omarquet/minitel-gpt/README.md

# MINITEL GPT

Transformer un **Minitel** en terminal de chat IA, servi par un conteneur
Docker hébergé sur un VPS, relié au Minitel par un
**ESP32** qui fait le pont entre le port série (DIN5, Vidéotex) et une
**WebSocket sécurisée (wss)**.

Fork de [jherard-fr/minitel-gpt](https://github.com/jherard-fr/minitel-gpt),
qui pilote le Minitel directement depuis un Raspberry Pi (port série local).
Ce fork remplace entièrement le Pi et le port série par la chaîne suivante :

```
Minitel --DIN5 1200 7E1--> ESP32 (UART) --WiFi wss://--> reverse proxy --> conteneur minitel-gpt
```

On tape sa question sur le clavier du Minitel, le serveur interroge le modèle
d'IA choisi - **Mistral**, **Claude** ou **Gemini** - et affiche la réponse à
l'écran, à 1200 bauds. Le fournisseur, la clé et le modèle se règlent depuis
l'interface web, tout comme la personnalité de l'assistant (la version phare
est « bloquée dans les années 80 »).

Deux pages viennent avec :

- **[La dictée vocale](#dicter-depuis-un-téléphone)** (`/dictee`) - on parle
  dans son téléphone, ça s'écrit sur le Minitel. Le clavier de 1982 reste sous
  les doigts de celui qui veut s'y frotter, et les autres dictent. Effet
  garanti.
- **[L'émulateur](#tester-sans-matériel)** (`/minitel.html`) - un Minitel
  complet dans le navigateur, même protocole que le vrai. De quoi tout essayer
  pendant que le tien attend encore son fer à souder.

---

## Déploiement

Voir [DEPLOY.md](DEPLOY.md) pour la procédure pas à pas (fork GitHub, serveur,
variables d'environnement, test sans matériel).

Variables d'environnement principales (`.env.example` à la racine) :

| Variable | Rôle |
|---|---|
| `LLM_PROVIDER` | `mistral` (défaut), `claude` ou `gemini` |
| `MISTRAL_KEY`, `MISTRAL_MODEL` | Clé et modèle Mistral |
| `ANTHROPIC_KEY`, `CLAUDE_MODEL` | Clé et modèle Claude |
| `GEMINI_KEY`, `GEMINI_MODEL` | Clé et modèle Gemini |
| `ADMIN_PASSWORD` | Mot de passe de l'admin web |
| `FLASK_SECRET` | Clé de signature des sessions Flask (mets une vraie valeur aléatoire en prod) |
| `ADMIN_PUBLIC_URL` | URL admin affichée sur le Minitel via la touche GUIDE |
| `WS_TOKEN` | Jeton requis en `?token=...` pour se connecter à `/ws` (voir [Sécurité](#sécurité)) |

## Tester sans matériel

Ouvre `https://<ton-domaine>/minitel.html` : un émulateur Minitel dans le
navigateur qui parle le même protocole WebSocket binaire que l'ESP32 (rendu
Vidéotex 40 colonnes, boutons pour les touches de fonction). L'URL WebSocket
et le jeton (`WS_TOKEN`) sont saisissables dans l'interface.

C'est le seul moyen d'essayer le serveur complet - personnalités, pagination,
touches de fonction - sans Minitel, sans ESP32 et sans la moindre soudure. Il
sert aussi à vérifier un déploiement avant de brancher le matériel.

## Dicter depuis un téléphone

Ouvre `https://<ton-domaine>/dictee` : une page pensée pour Safari sur iPhone,
qui écrit sur le Minitel **dans la session en cours**. Le clavier d'un Minitel
est lent et déroutant pour qui ne l'a jamais pratiqué ; là, le visiteur dicte
au micro du clavier natif de son téléphone et le texte s'affiche sur l'écran du
Minitel, caractère par caractère, comme s'il avait été tapé.

Deux modes : **Direct**, où le texte part au fil de la dictée, et **Valider**,
où l'on se relit avant d'envoyer. Les boutons `ENVOI` et `Effacer` reproduisent
les touches correspondantes.

Le téléphone ne se connecte pas à `/ws` - il ouvrirait une deuxième
conversation au lieu d'écrire dans celle du Minitel. Il passe par
`/dictee/inject`, qui dépose les caractères dans la session existante. Deux
conséquences à connaître :

- il faut **une session Minitel ouverte** ; sans elle, la page le dit et
  n'envoie rien ;
- ce qui est dicté pendant la lecture d'une réponse **attend son tour**, les
  caractères n'étant consommés que lorsque le terminal attend une question.

Le jeton (`WS_TOKEN`) se saisit une fois et reste dans le `localStorage` du
téléphone : la page est faite pour passer de main en main, le jeton n'y est
affiché nulle part. Un bouton permet de l'oublier.

## Sécurité

`/ws` (et les endpoints de test `/ws-echo`, `/ws-gemini`) n'ont **aucune
authentification par défaut** : n'importe qui connaissant l'URL publique peut
discuter avec l'assistant et consommer ta clé API. Configure `WS_TOKEN` (une
valeur aléatoire, ex. `python3 -c "import secrets; print(secrets.token_hex(32))"`)
pour exiger `?token=...` sur la connexion WebSocket. L'ESP32 doit alors inclure
le même jeton dans `WS_PATH` (voir le firmware).

Le même jeton protège les deux routes de données de la dictée,
`/dictee/status` et `/dictee/inject` (403 sans lui). La **page** `/dictee`,
elle, est servie sans jeton, volontairement : l'exiger le laisserait dans
l'URL, donc dans l'historique du téléphone. Elle ne contient aucun secret et
ne sert à rien sans jeton.

L'écran affiché sur la touche **GUIDE** ne montre que l'URL de l'admin, jamais
le mot de passe (contrairement au Pi d'origine, où seul le foyer avait un
accès physique au Minitel - ici `/ws` est public). Il permet aussi de changer
de personnalité active directement depuis le Minitel.

---

## Matériel (ESP32-C3)

> **Le firmware est écrit pour un ESP32-C3**, et son brochage lui est propre.
> Sur cette puce, UART0 sert à la console USB et **les GPIO11 à GPIO17 sont
> réservés à la mémoire flash** : les GPIO16/17 des projets ESP32 classiques
> sont donc inutilisables ici. Le pont utilise **UART1 sur GPIO4 (RX) et
> GPIO5 (TX)**. Pour une autre carte ESP32, seuls les numéros de broches et le
> numéro d'UART changent (en tête de `firmware/firmware.ino`) - le reste du
> code est portable.

| Élément | Détail |
|---|---|
| ESP32-C3 | Carte de dev WiFi. LED de statut sur `GPIO8` (logique inversée), bouton BOOT sur `GPIO9` |
| Adaptation de niveau | Une résistance de 10 k en pull-up, ou un TXS0108E - voir la fiche d'atelier |
| MP1584EN | Optionnel : abaisseur 12 V → 5 V pour alimenter l'ESP32 depuis le Minitel |
| Minitel | Prise DIN 5 broches « péri-informatique » |

> ⚠️ **Piège matériel** : le port DIN du Minitel est en **5 V**, les GPIO de
> l'ESP32-C3 en **3,3 V non tolérants 5 V**. Ne jamais relier la ligne TX du
> Minitel directement à une entrée.

> ⚠️ **Le brochage DIN-5 n'est pas séquentiel** : côté broches de la fiche mâle
> du câble (celle qu'on tient en main), c'est **3 - 5 - 2 - 4 - 1**.

### Câblage

| DIN Minitel | ESP32-C3 | Rôle |
|---|---|---|
| broche 1 | `GPIO5` (UART1 TX) | ESP32 → Minitel |
| broche 3 | `GPIO4` (UART1 RX), via pull-up ou TXS0108E | Minitel → ESP32 |
| broche 2 | `GND` | Masse commune |
| broche 5 | MP1584EN réglé à 5 V → broche `5V` | **12 V mesurés** : alimentation optionnelle, jamais en direct |
| broche 4 | **ne pas toucher** | 5 V mesurés, à isoler |

Paramètres série : **1200 bauds, 7 bits, parité paire, 1 stop (7E1)** - norme
Videotex, gérés par l'UART de l'ESP32 (`SERIAL_7E1`).

> 📄 **Le montage complet est décrit dans [`documentation/fiche-atelier.md`](documentation/fiche-atelier.md)**,
> imprimable en PDF : trois montages au choix, brochage détaillé, couleurs des
> fils, tests au multimètre et dépannage.

### Firmware

`firmware/firmware.ino` - relais transparent octet à octet entre
l'UART du Minitel et une connexion WebSocket cliente (lib **WebSockets** de
Markus Sattler / Links2004, disponible dans le gestionnaire de bibliothèques
Arduino). À configurer avant flash, dans `firmware/secrets.h` (modèle :
`secrets.h.example`) : réseaux WiFi, `WS_HOST_PROD`, `USE_LOCAL` et le jeton
`WS_TOKEN_ENC` URL-encodé. Le `.ino` ne contient aucune valeur d'installation
et refuse de compiler si l'une manque.

---

## Interface d'administration

`https://<ton-domaine>/` - mot de passe défini par `ADMIN_PASSWORD`.

- **Personnalités** : créer / modifier / supprimer des presets, prompt système
  en éditeur multi-lignes (laissé vide, le défaut du dépôt s'applique - voir
  plus bas), génération de prompt par IA, **fichiers de connaissance** (.txt)
  injectés dans le contexte, textes d'accueil personnalisables, zone de test
  sans le Minitel.
- **Paramètres** : choix du **fournisseur d'IA** (Mistral, Claude, Gemini) avec
  la clé et le modèle de chacun, logs.

Les personnalités sont stockées dans `config/prompts.json` (créé au premier
démarrage depuis `config/prompts.default.json`, non versionné), leurs fichiers
de connaissance dans `config/knowledge/<personnalité>/` - tout ça vit dans le
volume Docker persistant, pas dans le dépôt git.

Le prompt système se lit en **deux couches** :

1. le champ `prompt` de `config/prompts.json`, s'il est renseigné - c'est la
   personnalisation écrite depuis l'admin web ;
2. sinon le fichier texte désigné par `prompt_file`, dans `config/prompts/` -
   c'est le défaut fourni par le dépôt.

Le défaut reste donc **vivant** : tant que personne n'a rien saisi dans l'admin,
modifier le `.txt` du dépôt et redéployer suffit à changer la personnalité. Un
`.txt` est bien plus lisible qu'une chaîne JSON échappée sur une seule ligne.
L'admin affiche sous le champ lequel des deux est utilisé ; un champ vide n'est
pas un prompt vide.

> Les personnalités/prompts sont pris en compte immédiatement (relus à chaque
> conversation). En revanche, changer la clé/le fournisseur LLM dans
> **Paramètres** ne s'applique au terminal Minitel qu'après un redéploiement
> du serveur (les mises à jour de code aussi passent par un redéploiement après
> `git push`, plus de bouton "mettre à jour" dans l'admin).

---

## Touches du Minitel

| Touche | Effet |
|---|---|
| **ENVOI** | Envoie la question tapée |
| **SOMMAIRE** | Retour au menu principal (recharge le preset, réinitialise la conversation) |
| **GUIDE** | Change de personnalité active (touche numérique), affiche aussi l'URL de l'admin |
| **RETOUR** / **CORRECTION** | Efface le dernier caractère tapé. Pendant la lecture d'une réponse multi-pages, RETOUR revient à la page précédente (autant de fois que nécessaire). Une fois la question suivante affichée (saisie vide), RETOUR rouvre directement l'avant-dernière page de la dernière réponse (pas la dernière, déjà vue) - SUITE termine la révision |
| **ANNULATION** | Efface toute la phrase en cours de saisie |
| **REPETITION** | Réaffiche la dernière réponse de l'assistant (sans nouvel appel API) |
| **SUITE** | Page suivante (réponse sur plusieurs écrans) |

---

## Arborescence

```
services/
  server.py             point d'entrée VPS : admin + WebSocket /ws
  minitel_gpt.py        écrans, lecture clavier, appel LLM (Mistral/Claude/Gemini)
  admin_ui.py           interface web d'admin
config/
  prompts.default.json  personnalités par défaut (prompts.json créé au 1er boot)
  prompts/*.txt         prompts système par défaut, référencés par `prompt_file`
firmware/
  firmware.ino          pont UART <-> WebSocket (sketch Arduino)
  secrets.h.example     modèle de secrets.h (WiFi + token WS, non versionné)
minitel.html             émulateur Minitel dans le navigateur (test sans matériel)
dictee.html              page de dictée vocale depuis un téléphone (servie sur /dictee)
Dockerfile, docker-compose.yml, entrypoint.sh
DEPLOY.md                procédure de déploiement
```

---

## Dépannage

| Symptôme | Cause probable |
|---|---|
| 502 Bad Gateway sur toutes les routes | conteneur pas démarré/joignable - vérifie les logs du serveur et le port du healthcheck (doit être celui de `EXPOSE` dans le Dockerfile, pas un défaut générique) |
| `minitel.html` ne se connecte pas | mauvais protocole (`wss://` pas `ws://` derrière le reverse proxy/HTTPS), `WS_TOKEN` manquant dans l'URL si configuré côté serveur, ou pas de port dans l'URL publique (le reverse proxy route en 443 en interne vers le port du conteneur) |
| Erreur API (401/403) sur les réponses | clé du fournisseur actif (`LLM_PROVIDER`) absente ou invalide |
| Rien ne s'affiche sur le vrai Minitel | câblage DIN délogé, level shifter absent/mal branché, broche 4 pontée par erreur, ou brochage DIN mal identifié (l'ordre physique n'est pas 1-2-3-4-5, voir plus haut) |
| Charabia à l'écran | vitesse ESP32 ≠ vitesse Minitel (rester à 1200 bauds 7E1 des deux côtés) |

---

*Projet personnel de Jérôme Hérard pour la version originale Raspberry Pi.*
