omarquet/minitel-gpt/DEPLOY.md

# Déploiement minitel-gpt sur VPS (ESP32 + WebSocket)

Ce dépôt tourne en conteneur Docker (Flask + gunicorn), sans dépendance au
matériel Raspberry Pi de l'upstream d'origine.

## 1. Récupérer le dépôt

Fork ou clone direct de https://github.com/omarquet/minitel-gpt selon ton
usage.

## 2. Déploiement sur ton serveur

1. Nouvelle app/service à partir de ton fork, en Docker Compose (ou Dockerfile).
2. Environment :
   - `LLM_PROVIDER=mistral` (ou `claude` / `gemini`)
   - `MISTRAL_KEY=...`  `MISTRAL_MODEL=mistral-small-latest` (si `LLM_PROVIDER=mistral`)
   - `ANTHROPIC_KEY=...`  `CLAUDE_MODEL=claude-haiku-4-5` (si `LLM_PROVIDER=claude`)
   - `GEMINI_KEY=...`  `GEMINI_MODEL=gemini-3.5-flash-lite` (si `LLM_PROVIDER=gemini`)
   - `ADMIN_PASSWORD=...`  `FLASK_SECRET=...`
   - `ADMIN_PUBLIC_URL=https://minitel.tondomaine.fr`
   - `WS_TOKEN=...` (recommandé) : sans ça, `/ws` est ouvert à qui connaît
     l'URL et peut consommer ta clé API. Avec un token, l'ESP32 et tes tests
     doivent ajouter `?token=...` à l'URL WebSocket.

   Les clés et modèles des trois fournisseurs cohabitent : basculer de l'un à
   l'autre ne fait pas perdre la configuration des autres. Les identifiants de
   modèles vieillissent vite - Google a retiré `gemini-2.0-flash`, qui répond
   maintenant `404 no longer available`. La liste à jour est celle des
   sélecteurs de l'admin (onglet **Paramètres**).
3. Domaine `minitel.tondomaine.fr`, port exposé **8080** (le reverse proxy gère TLS + WebSocket).
   ⚠️ Vérifie aussi le **port du healthcheck** dans la config de ton serveur : il
   revient parfois à une valeur par défaut (ex. 3000) qui ne correspond pas au
   port réel du conteneur (8080) - ça provoque un 502 permanent même si l'app
   tourne parfaitement (visible dans les logs : `Healthcheck URL: .../3000/healthz`).
4. Déploie.
   - Admin : `https://minitel.tondomaine.fr/`
   - Endpoint Minitel/ESP32 : `wss://minitel.tondomaine.fr/ws`

## 3. Tester sans ESP32

En local :
```bash
docker compose up --build
```
Ouvre `minitel.html`, URL `ws://localhost:8080/ws`, clique **Connecter**.
Tape une question, **Entrée** = ENVOI ; boutons SUITE / SOMMAIRE / GUIDE.

Une fois déployé sur ton serveur, pointe l'émulateur sur `wss://minitel.tondomaine.fr/ws`
pour valider le VPS avant toute soudure.

## 4. Matériel ESP32 (rappel critique)

Le port DIN du Minitel est en **5 V**, les GPIO de l'ESP32 en **3,3 V non
tolérants 5 V**. Un **adaptateur de niveau logique bidirectionnel** (BSS138 /
TXS0108E) est obligatoire entre les deux. Câblage détaillé dans le `.ino`.
