omarquet/minitel-gpt/firmware/firmware.ino

/*
 * minitel_esp32_bridge.ino
 * ------------------------------------------------------------------
 * Pont TRANSPARENT entre le Minitel (UART DIN5, 1200 7E1) et le service
 * minitel-gpt heberge sur le VPS Coolify, via WebSocket securise (wss).
 *
 * L'ESP32 ne fait AUCUN traitement Videotex : il relaie les octets bruts.
 *   Minitel -> UART RX -> WebSocket (frame binaire) -> serveur
 *   serveur  -> WebSocket (frame binaire) -> UART TX -> Minitel
 *
 * Librairie requise : "WebSockets" de Markus Sattler (Links2004)
 *   -> Gestionnaire de bibliotheques Arduino : chercher "WebSockets by Markus Sattler"
 *
 * CIBLE : ESP32-C3 (RISC-V). ATTENTION, le C3 n'a que DEUX UART (UART0 et
 * UART1) : il n'existe pas d'UART2. UART0 sert a la console USB/debug, on
 * utilise donc UART1. De plus, sur le C3 les GPIO11 a GPIO17 sont reserves a
 * la memoire flash : les GPIO16/17 du projet d'origine sont INUTILISABLES.
 *
 * ============================ CABLAGE ============================
 * DIN5 peri-informatique Minitel  <->  ESP32-C3 (UART1)
 *   DIN broche 1 (Minitel RX)  <-  ESP32-C3 TX (GPIO5)  [via level shifter]
 *   DIN broche 3 (Minitel TX)  ->  ESP32-C3 RX (GPIO4)  [via level shifter]
 *   DIN broche 2 (GND)         <-> ESP32 GND
 *   DIN broche 4 : ne pas toucher.
 *
 * !!! ORDRE DE BRANCHEMENT !!!
 * Le VB du TXS0108E est pris sur la broche 5V de l'ESP32-C3, qui EST le VBUS
 * de l'USB : USB debranche, elle est flottante. Si on branche le DIN en
 * premier, le 5 V du Minitel remonte par les diodes de protection et alimente
 * partiellement la carte (la LED d'alim s'allume faiblement) : rails a une
 * tension partielle, tout est dans un etat indetermine, et le TXS0108E voit
 * VB s'etablir avant VA, l'inverse de ce que demande sa datasheet.
 *   -> BRANCHER : USB d'abord, DIN ensuite.
 *   -> DEBRANCHER : DIN d'abord, USB en dernier.
 *
 * !!! DIN BROCHE 5 : 12 V MESURES sur ce Minitel 2 Alcatel !!!
 * Ne JAMAIS relier cette broche a l'ESP32, ni sur 3V3, ni sur 5V/VIN : sur
 * les petites cartes C3, 5V est cablee au VBUS de l'USB et le regulateur
 * 3,3 V embarque plafonne vers 6 V d'entree -> carte detruite.
 * Pour un montage autonome alimente par le Minitel (sans USB) :
 *   broche 5 -> buck DC-DC 12 V vers 5 V (MP1584, LM2596), tension VERIFIEE
 *   au voltmetre avant branchement -> pin 5V de l'ESP32 + VB du TXS0108E.
 *   Condensateur 470-1000 uF sur le rail 5 V pres de l'ESP32 (les pics de
 *   courant du WiFi font decrocher les petits bucks).
 *   NE PAS cumuler l'USB du Mac et le buck : conflit VBUS / sortie buck sur
 *   le meme rail. Debrancher l'un pour utiliser l'autre (ou diode Schottky
 *   en serie sur la sortie du buck).
 *   Le courant disponible sur la broche 5 est faible et mal documente : le
 *   mesurer en charge WiFi avant de considerer le montage fiable.
 *
 * MODE PERI-INFORMATIQUE FORCE AU DEMARRAGE
 * ------------------------------------------
 * setup() envoie une sequence PRO3 (voir forcerModePeriInformatique()) qui
 * demande au Minitel de router son clavier et son ecran vers la prise
 * peri-informatique, a la place de "Fnct+T puis A" tape a la main. Repetee
 * pendant FORCE_MODE_WINDOW_MS apres le boot (idleTick()/loop()) : le
 * Minitel peut encore etre en train de demarrer lui-meme au moment du tout
 * premier envoi, qui serait alors perdu en silence. Experimental, non
 * verifie sur ce modele (Minitel 2 Alcatel) : si le clavier ne remonte
 * toujours pas sans la manip manuelle, cette sequence n'a pas suffi.
 *
 * CONFIGURATION WIFI SANS ORDINATEUR
 * ----------------------------------
 * Au demarrage, dans l'ordre : le reseau memorise en NVS (choisi une fois sur
 * l'ecran du Minitel), puis la liste WIFI_SSID / WIFI_SSID2 / WIFI_SSID3 de
 * secrets.h. Si rien ne repond, l'ESP32 prend la parole sur le Minitel et
 * propose les reseaux du scan, numerotes : on choisit au chiffre (le SSID ne
 * se tape donc jamais), on saisit le mot de passe, et le reseau retenu est
 * memorise pour les demarrages suivants.
 * Effacer ce reseau memorise : "O" dans ce menu, ou BOOT maintenu 5 s en
 * fonctionnement - le seul recours quand la carte est connectee a un reseau
 * dont on ne veut plus, le menu ne s'affichant alors jamais.
 *
 * Broches C3 a EVITER : GPIO11-17 (flash), GPIO18/19 (USB natif),
 * GPIO20/21 (UART0 console), GPIO2/9 (strapping au boot).
 * GPIO4 et GPIO5 sont libres et sans contrainte de boot.
 * GPIO8 est un strapping pin mais porte la LED de statut de la carte : elle
 * n'est pilotee qu'apres le boot, et son etat de repos est l'etat haut.
 *
 * !!! IMPORTANT NIVEAUX LOGIQUES !!!
 * Le port peri-info du Minitel est en 5 V (c'est pourquoi le projet d'origine
 * met le cavalier FTDI sur 5 V). Or les GPIO de l'ESP32-C3 sont en 3.3 V et NE
 * SONT PAS tolerants 5 V. Il FAUT un adaptateur de niveau logique bidirectionnel
 * (ex. module a base de BSS138, ou TXS0108E) entre le Minitel et l'ESP32 :
 *   - obligatoire sur la ligne Minitel TX (5 V) -> ESP32 RX, sinon tu grilles le GPIO
 *   - recommande aussi sur ESP32 TX (3.3 V) -> Minitel RX pour une marge propre
 * ================================================================
 */

#include <WiFi.h>
#include <Preferences.h>
#include <WiFiClientSecure.h>
#include <WebSocketsClient.h>
#include <esp_system.h>   // esp_reset_reason() : cause du dernier demarrage
// WIFI_SSID / WIFI_PASSWORD / WS_TOKEN_ENC. Fichier ignore par git : le creer
// a partir de secrets.h.example (meme dossier).
#include "secrets.h"

// ============ A CONFIGURER ============
// Serveur, port et transport : dans secrets.h (modele : secrets.h.example).
// Rien de tout cela n'a sa place ici - firmware.ino est du code, pas la
// configuration d'une machine : un nom de domaine ou une IP locale versionnes,
// c'est du fichier suivi par git qu'il faut modifier pour un simple test.
//   USE_LOCAL 1 = serveur sur ta machine, ws:// non chiffre  -> WS_HOST_LOCAL
//   USE_LOCAL 0 = production derriere un reverse proxy, wss:// -> WS_HOST_PROD
#ifndef USE_LOCAL
  #error "secrets.h doit definir USE_LOCAL (voir secrets.h.example)"
#endif
#if USE_LOCAL
  #if !defined(WS_HOST_LOCAL) || !defined(WS_PORT_LOCAL)
    #error "USE_LOCAL 1 : secrets.h doit definir WS_HOST_LOCAL et WS_PORT_LOCAL"
  #endif
#else
  #if !defined(WS_HOST_PROD) || !defined(WS_PORT_PROD)
    #error "USE_LOCAL 0 : secrets.h doit definir WS_HOST_PROD et WS_PORT_PROD"
  #endif
#endif

// 0 = fonctionnement normal.
// 1 = trace sur le moniteur serie tout ce qui arrive du Minitel.
//     Rien = le Minitel n'emet pas. Bons caracteres = liaison OK.
//     Octets incoherents = mauvaise vitesse/format.
// 2 = comme 1, plus emission du motif de test toutes les 2 s. Permet de
//     sonder la ligne au voltmetre et de faire un test de bouclage
//     (GPIO4 relie a GPIO5) sans dependre du timing du RESET.
#define DEBUG_UART 0

#if USE_LOCAL
  const char* WS_HOST = WS_HOST_LOCAL;
  const int   WS_PORT = WS_PORT_LOCAL;
#else
  const char* WS_HOST = WS_HOST_PROD;
  const int   WS_PORT = WS_PORT_PROD;
#endif

// Pour isoler un souci materiel : basculer sur "/ws-echo", ou le serveur
// renvoie les octets tels quels sans appeler le LLM. Revenir a "/ws" ensuite.
#define WS_ENDPOINT "/ws"

// Le serveur (WS_TOKEN) ferme la connexion en SILENCE si le token est absent
// ou faux : symptome = "[WS] connecte" puis "[WS] deconnecte" en boucle.
const char* WS_PATH = WS_ENDPOINT "?token=" WS_TOKEN_ENC;
// ======================================

// UART1 vers le Minitel : 1200 bauds, 7 bits de donnees, parite paire, 1 stop.
// (UART1 et non UART2 : le C3 ne possede pas de troisieme UART.)
// Reseaux connus, essayes dans l'ordre. Les entrees 2 et 3 n'existent que si
// secrets.h les definit : un secrets.h d'avant cette liste continue de
// marcher tel quel, avec un seul reseau.
struct WifiNet { const char* ssid; const char* pass; };
static const WifiNet KNOWN_NETS[] = {
  { WIFI_SSID, WIFI_PASSWORD },
#ifdef WIFI_SSID2
  { WIFI_SSID2, WIFI_PASSWORD2 },
#endif
#ifdef WIFI_SSID3
  { WIFI_SSID3, WIFI_PASSWORD3 },
#endif
};
static const uint8_t KNOWN_COUNT = sizeof(KNOWN_NETS) / sizeof(KNOWN_NETS[0]);
// Identifiants reellement utilises, quelle que soit leur origine : NVS, liste
// de secrets.h ou ecran de configuration. Le filet de reconnexion du loop doit
// relancer CEUX-LA - sinon, connecte via l'ecran de configuration, il tentait
// le premier reseau de secrets.h, qui n'est justement pas la.
static String usedSsid, usedPass;
// Delai laisse a chaque reseau avant de passer au suivant. Assez long pour un
// DHCP lent, assez court pour faire le tour d'une liste de trois sans lasser.
#define WIFI_TRY_MS 12000
// Reseau absent du dernier scan : il peut etre a SSID cache, donc on l'essaie
// quand meme - mais sans y consacrer les 12 s d'un reseau qu'on a vu.
#define WIFI_TRY_ABSENT_MS 4000
// Tours de liste avant de renoncer et d'ouvrir l'ecran de configuration.
#define WIFI_PASSES 3

#define MINITEL_RX 4    // ESP32-C3 RX  <- Minitel TX (broche DIN 3)
#define MINITEL_TX 5    // ESP32-C3 TX  -> Minitel RX (broche DIN 1)
HardwareSerial Minitel(1);

// ---------------------------------------------------------------------------
// Aiguillage automatique en mode peri-informatique (protocole Teletel)
//
// Remplace la manip manuelle "Fnct+T puis A" : la couche "Protocole" du
// Minitel route normalement le clavier vers son modem interne (mode
// Videotex) ; on lui demande ici de router clavier <-> prise
// peri-informatique a la place, par une sequence PRO3 envoyee sur la liaison
// serie elle-meme (rien a cabler de plus, deja sur GPIO5).
//
// Sequence documentee pour le Minitel 1B (bibliotheque Arduino
// Minitel1B_Hard, fonction aiguillage()) : ESC 0x3B (PRO3), AIGUILLAGE_ON,
// recepteur, emetteur. NON VERIFIEE sur ce Minitel 2 Alcatel - la couche
// Protocole fait partie de la norme Teletel commune a toute la gamme, mais
// personne ne l'a encore confirme sur ce modele precis. A surveiller au
// premier essai reel : si le clavier ne remonte toujours pas sans
// Fnct+T+A manuel, cette fonction n'a pas eu l'effet attendu.
#define PRO3           0x3B
#define AIGUILLAGE_ON  0x61
#define CODE_ECRAN     0x58   // reception ecran
#define CODE_CLAVIER   0x51   // emission clavier
#define CODE_PRISE_EM  0x53   // emission prise peri-informatique
#define CODE_PRISE_REC 0x5B   // reception prise peri-informatique

// Date du dernier octet envoye au Minitel. Sert au battement de coeur plus
// bas : seule une ligne SILENCIEUSE doit en recevoir un.
static unsigned long dernierEnvoiMinitelMs = 0;

void aiguillage(uint8_t recepteur, uint8_t emetteur) {
  dernierEnvoiMinitelMs = millis();
  Minitel.write(0x1B);         // ESC
  Minitel.write(PRO3);
  Minitel.write(AIGUILLAGE_ON);
  Minitel.write(recepteur);
  Minitel.write(emetteur);
}

void forcerModePeriInformatique() {
  aiguillage(CODE_PRISE_REC, CODE_CLAVIER);   // clavier -> prise (sens montant)
  aiguillage(CODE_ECRAN, CODE_PRISE_EM);      // prise -> ecran (sens descendant)
  Serial.println("[Minitel] aiguillage force vers la prise peri-informatique (PRO3)");
}

// Un seul envoi ferait reposer tout le mecanisme sur un delai devine : le
// Minitel peut encore etre en train de demarrer lui-meme (sortie de veille,
// reset interne) au moment ou l'ESP32 envoie sa toute premiere sequence,
// qui serait alors perdue en silence. On la repete donc pendant une dizaine
// de secondes plutot que de parier sur un seul instant - inoffensif si le
// Minitel a deja bascule, ca ne fait que reaffirmer le meme aiguillage. La
// fenetre est large parce que le Minitel peut sortir de veille bien apres
// l'ESP32 : mieux vaut insister trop longtemps que rater le reveil.
#define FORCE_MODE_WINDOW_MS 10000  // duree totale des tentatives apres le boot
#define FORCE_MODE_PERIOD_MS 500    // intervalle entre deux tentatives
static unsigned long forceModeUntilMs = 0;
static unsigned long lastForceModeMs = 0;

// A appeler quand on s'apprete a ECRIRE sur le Minitel, et seulement la :
// avant l'ecran de configuration, et une fois le WiFi obtenu. Tant qu'on
// cherche un reseau, le terminal ne doit pas etre touche - on n'a rien a lui
// montrer, et le basculer pour rien lui fait perdre l'affichage qu'il avait.
void ouvrirFenetreAiguillage() {
  forceModeUntilMs = millis() + FORCE_MODE_WINDOW_MS;
  forcerModePeriInformatique();          // premier envoi immediat
  lastForceModeMs = millis();            // les suivants passent par idleTick()/loop()
}


// Le Minitel eteint son ecran quand plus aucun caractere ne lui parvient. La
// STUM 2 documente ce mecanisme avec un delai de trois heures ; celui du
// montage s'endort en cinq a dix minutes, et une session ou personne ne tape
// laisse la ligne parfaitement muette bien plus longtemps que ca. Un octet
// suffit a reculer l'echeance : NUL est un caractere de remplissage Videotex,
// sans aucun effet a l'ecran.
//
// La condition "rien envoye depuis VEILLE_KEEPALIVE_MS" garantit qu'on ne
// s'insere jamais au milieu d'une sequence d'echappement du serveur : par
// construction, on n'ecrit que sur une ligne au repos.
#define VEILLE_KEEPALIVE_MS 120000   // 2 min

void maybeReveilMinitel() {
  if (millis() - dernierEnvoiMinitelMs < VEILLE_KEEPALIVE_MS) return;
  Minitel.write((uint8_t) 0x00);
  dernierEnvoiMinitelMs = millis();
}


void maybeForceModePeriInformatique() {
  if (millis() >= forceModeUntilMs) return;
  if (millis() - lastForceModeMs < FORCE_MODE_PERIOD_MS) return;
  lastForceModeMs = millis();
  forcerModePeriInformatique();
}

// LED de statut integree a la carte, sur GPIO8, en logique INVERSEE.
// GPIO8 est une broche de strapping (doit etre a l'etat haut au boot) : on ne
// la pilote qu'apres le demarrage, et l'etat de repos LED_OFF est justement
// HIGH, donc un reset pendant une phase eteinte demarre normalement.
// Codage : flash bref toutes les 2 s = tout va bien (prouve aussi que loop()
// tourne encore), clignotement lent = WiFi OK mais WebSocket coupee,
// clignotement rapide = WiFi perdu.
#define STATUS_LED 8
#define LED_ON     LOW
#define LED_OFF    HIGH

// Bouton BOUT de la carte. GPIO9 est la broche de strapping qui choisit le
// mode de demarrage : maintenue basse AU RESET, la puce entre en mode
// televersement et n'execute pas ce firmware. On ne la lit donc jamais au
// demarrage, seulement pendant le fonctionnement - ou elle redevient une
// entree ordinaire avec sa resistance de tirage interne.
#define BOOT_BTN 9
// Cinq secondes : BOOT est le SEUL bouton de la carte et un visiteur curieux
// appuiera dessus. Assez long pour etre delibere, assez court pour qu'on ne
// relache pas en croyant que ca ne marche pas.
#define RESET_HOLD_MS 5000
// Appui BREF sur le meme bouton : ouvre l'ecran de configuration sans attendre
// le tour complet des reseaux connus. Demande a la main, pendant qu'on est
// devant le Minitel, plutot que subie apres 36 s d'essais.
#define RESET_TAP_MIN_MS 50
static volatile bool setupRequested = false;

// Reseau appris a l'ecran de configuration, garde en NVS. C'est lui qu'on
// essaie EN PREMIER au demarrage : une fois configure sur place, le boitier
// s'y reconnecte seul.
Preferences prefs;
#define NVS_NS "wifi"

WebSocketsClient webSocket;
bool wsConnected = false;

// Petit tampon pour regrouper les octets clavier avant envoi (moins de frames)
uint8_t txBuf[64];
size_t  txLen = 0;
unsigned long lastByteMs = 0;

// Non bloquant : la phase se deduit de millis(), aucune variable d'etat.
void updateStatusLed() {
  unsigned long onMs, periodMs;
  if (WiFi.status() != WL_CONNECTED) {
    onMs = 100; periodMs = 200;            // rapide : pas de WiFi
  } else if (!wsConnected) {
    onMs = 500; periodMs = 1000;           // lent : WiFi OK, WebSocket coupee
  } else {
    onMs = 50;  periodMs = 2000;           // flash bref : tout va bien
  }
  digitalWrite(STATUS_LED, (millis() % periodMs) < onMs ? LED_ON : LED_OFF);
}

void flushTx() {
  if (txLen == 0) return;
  if (wsConnected) {
    webSocket.sendBIN(txBuf, txLen);
  }
  // Deconnecte : on JETTE ce qui a ete tape pendant la coupure. Sinon le
  // tampon reste plein (frappes suivantes perdues en silence) et se deverse
  // dans la session neuve d'apres reconnexion, comme une question fantome.
  txLen = 0;
}

void onWsEvent(WStype_t type, uint8_t* payload, size_t length) {
  switch (type) {
    case WStype_CONNECTED:
      wsConnected = true;
      Serial.println("[WS] connecte au serveur minitel-gpt");
      break;
    case WStype_DISCONNECTED:
      wsConnected = false;
      Serial.printf("[WS] deconnecte (WiFi status=%d, RSSI=%d dBm)\n",
                    WiFi.status(), WiFi.RSSI());
      break;
    case WStype_ERROR:
      Serial.printf("[WS] erreur (%u octets)\n", (unsigned) length);
      break;
    case WStype_BIN:
    case WStype_TEXT:
      // Octets Videotex venant du serveur -> ecran Minitel, tels quels.
#if DEBUG_UART
      // Trace compacte du sens descendant : taille + 16 premiers octets.
      Serial.printf("[TX] %u o :", (unsigned) length);
      for (size_t i = 0; i < length && i < 16; i++) Serial.printf(" %02X", payload[i]);
      Serial.println(length > 16 ? " ..." : "");
#endif
      Minitel.write(payload, length);
      dernierEnvoiMinitelMs = millis();
      break;
    default:
      break;
  }
}

// ---------------------------------------------------------------------------
// Configuration WiFi depuis le Minitel
//
// L'ESP32 parle ici au terminal LUI-MEME, en Videotex, avant d'ouvrir la
// WebSocket : le pont reste strictement octet a octet, aucune machine a etats
// ne peut avaler une frappe une fois la conversation demarree.
// Le SSID ne se tape jamais - il se choisit dans la liste du scan, ce qui
// evite d'avoir a saisir sa casse et ses symboles au clavier Minitel. Le mot
// de passe, lui, s'affiche en clair : c'est assume.
// ---------------------------------------------------------------------------
#define MAX_NETS 27              // 3 pages de 9 : au-dela c'est du bruit de fond
#define PER_PAGE 9               // un seul chiffre a taper, jamais deux
#define SETUP_IDLE_MS 120000     // sans frappe : on repart tenter les reseaux connus
static String netSsid[MAX_NETS];
static int8_t netRssi[MAX_NETS];
// Nombre de bornes diffusant ce meme nom. Un reseau maille en compte plusieurs,
// et c'est une cause classique d'association qui n'aboutit pas : la carte vise
// le nom, pas la borne, et peut s'adresser a la plus lointaine.
static uint8_t netBornes[MAX_NETS];
// Date du dernier scan : savoir si un reseau est la n'a de sens qu'avec un
// releve recent.
static unsigned long scanDate = 0;
#define SCAN_FRAIS_MS 60000
static uint8_t netCount = 0;

void mnClear() { dernierEnvoiMinitelMs = millis(); Minitel.write(0x0C); }
void mnLine(const char* s = "") {
  dernierEnvoiMinitelMs = millis();
  Minitel.print(s); Minitel.write(0x0D); Minitel.write(0x0A);
}

// Touche lue, 0 si rien. Les touches de fonction arrivent en SEP + code : on
// renvoie ce code avec le bit 0x80 mis, pour le distinguer d'un caractere.
#define K_ENVOI_M  (0x80 | 0x41)
#define K_SOM_M    (0x80 | 0x46)
#define K_CORR_M   (0x80 | 0x47)
#define K_SUITE_M  (0x80 | 0x48)
uint8_t mnKey() {
  if (!Minitel.available()) return 0;
  uint8_t b = (uint8_t) Minitel.read();
  if (b != 0x13) return b;                               // caractere ordinaire
  unsigned long t0 = millis();
  while (!Minitel.available() && millis() - t0 < 500) delay(1);
  return Minitel.available() ? (0x80 | (uint8_t) Minitel.read()) : 0;
}

void forgetSaved() {
  prefs.begin(NVS_NS, false);
  prefs.clear();
  prefs.end();
  Serial.println("[WiFi] reseau memorise efface");
}

bool hasSaved() {
  prefs.begin(NVS_NS, true);
  bool ok = prefs.getString("ssid", "").length() > 0;
  prefs.end();
  return ok;
}

// Appui long sur BOOT : efface le reseau memorise et redemarre sur la liste
// de secrets.h. Non bloquant, appele depuis toutes les boucles d'attente -
// c'est le seul recours quand la carte est connectee a un reseau dont on ne
// veut plus, l'ecran de configuration ne s'affichant alors jamais.
void checkResetButton() {
  static unsigned long downSince = 0;
  if (digitalRead(BOOT_BTN) == LOW) {
    if (downSince == 0) downSince = millis();
    digitalWrite(STATUS_LED, LED_ON);        // fixe : aucun autre etat ne l'est
    if (millis() - downSince >= RESET_HOLD_MS) {
      forgetSaved();
      for (uint8_t i = 0; i < 3; i++) {      // 3 flashs : c'est efface
        digitalWrite(STATUS_LED, LED_OFF); delay(120);
        digitalWrite(STATUS_LED, LED_ON);  delay(120);
      }
      Serial.flush();
      ESP.restart();
    }
  } else {
    // Relachement : un appui bref demande l'ecran de configuration, un appui
    // long a deja fait son office (effacement + redemarrage) sans revenir ici.
    if (downSince != 0 && millis() - downSince >= RESET_TAP_MIN_MS) {
      setupRequested = true;
      Serial.println("[BOOT] appui bref -> ecran de configuration WiFi");
    }
    downSince = 0;
  }
}

// Attente active commune : la LED continue de vivre, le bouton reste lu, et
// les tentatives d'aiguillage se poursuivent meme si le WiFi met du temps a
// se connecter (l'ecran de configuration peut a lui seul tenir plusieurs
// dizaines de secondes, largement au-dela de FORCE_MODE_WINDOW_MS sinon).
void idleTick() {
  updateStatusLed(); checkResetButton();
  maybeForceModePeriInformatique(); maybeReveilMinitel();
  delay(5);
}

// Pourquoi une connexion echoue. Sans cette raison, le journal disait "pas de
// reponse" pour TOUT - mot de passe faux, reseau absent, box qui refuse - et il
// ne restait qu'a deviner. La pile, elle, sait : elle la donne dans l'evenement
// de deconnexion.
static volatile uint8_t derniereRaisonWifi = 0;

// Notre propre arret a-t-il ete acte par la pile ? Pose par l'evenement de
// deconnexion, attendu par demarrerConnexion() avant de reconfigurer.
static volatile bool arretWifiConfirme = false;

void onWifiEvent(WiFiEvent_t evt, WiFiEventInfo_t info) {
  if (evt != ARDUINO_EVENT_WIFI_STA_DISCONNECTED) return;
  uint8_t r = info.wifi_sta_disconnected.reason;
  // 36 (STA_LEAVING) et 8 (ASSOC_LEAVE), c'est NOUS qui partons : le
  // WiFi.disconnect() pose avant chaque tentative emet cet evenement. Le
  // retenir affichait notre propre depart comme si la box avait refuse -
  // "raison 36" sur deux essais de suite, alors qu'aucun refus n'etait venu.
  if (r == WIFI_REASON_STA_LEAVING || r == WIFI_REASON_ASSOC_LEAVE) {
    arretWifiConfirme = true;   // c'est le signal qu'attend demarrerConnexion()
    return;
  }
  derniereRaisonWifi = r;
}

const char* raisonWifi(uint8_t r) {
  switch (r) {
    case 0:   return "AUCUN refus recu : le point d'acces n'a jamais repondu "
                     "(emission de la carte ? antenne ?)";
    case WIFI_REASON_AUTH_EXPIRE:            return "authentification expiree";
    case WIFI_REASON_ASSOC_EXPIRE:           return "association expiree";
    case WIFI_REASON_4WAY_HANDSHAKE_TIMEOUT: return "MOT DE PASSE refuse (handshake)";
    case WIFI_REASON_NO_AP_FOUND:            return "RESEAU INTROUVABLE : nom exact ? hors de portee ? 5 GHz (le C3 ne voit que le 2,4) ?";
    case WIFI_REASON_AUTH_FAIL:              return "AUTHENTIFICATION refusee (mot de passe ?)";
    case WIFI_REASON_ASSOC_FAIL:             return "association refusee par la box";
    case WIFI_REASON_HANDSHAKE_TIMEOUT:      return "handshake expire";
    case WIFI_REASON_CONNECTION_FAIL:        return "connexion refusee";
    default:                                 return "voir WIFI_REASON_* dans esp_wifi_types.h";
  }
}


// Annuler la tentative precedente SANS couper la radio. Il faut bien l'annuler :
// si elle est encore en cours - ce qui arrive des que WIFI_TRY_MS expire avant
// que la pile n'ait termine - le pilote refuse la nouvelle configuration
// ("E wifi:sta is connecting, cannot set config") et le WiFi.begin() qui suit
// est IGNORE en silence ; le reseau suivant de la liste n'etait alors jamais
// essaye. Mais esp_wifi_disconnect() suffit a cela : c'est ce que fait
// WiFi.disconnect(false).
//
// La version precedente coupait la radio (disconnect(true)). Trop brutal :
// scanNets() vient deja de l'eteindre pour scanner, et le PREMIER essai qui
// suit - donc apres deux extinctions coup sur coup - echouait par
// intermittence en "association expiree" (raison 4), y compris a -35 dBm,
// pendant que le second essai passait. Ce qui manquait n'etait pas la
// brutalite mais le temps de se ranger.
//
// Le message a fini par reapparaitre, sur un demarrage ou les essais 2 et 3
// ont ete refuses coup sur coup (16 225 ms et 20 483 ms au log) : la pause
// fixe de 250 ms etait bel et bien trop courte. On n'en devine donc plus la
// duree - c'est le troisieme delai qu'on aurait devine, apres les deux
// racontes ci-dessus. On attend le signal que la pile emet elle-meme quand
// l'arret est acte (STA_LEAVING / ASSOC_LEAVE, cf. onWifiEvent), avec un
// plafond pour le cas ou il ne vient pas - une station deja au repos n'a
// rien a annoncer, et l'attente se termine alors sur le plafond court.
//
// Et surtout, on regarde ce que repond WiFi.begin() : c'est ce test qui
// supprime vraiment la panne. Meme si l'attente se revelait un jour trop
// courte, le refus devient visible et rattrapable au lieu de couter un essai
// entier a viser dans le vide.
// Ce reseau figure-t-il dans le dernier scan, et est-il assez recent pour
// qu'on s'y fie ? Retourne son index, ou -1.
#define ARRET_WIFI_PLANCHER_MS 250  // duree mini avant de reconfigurer
#define ARRET_WIFI_COURT_MS 300    // station probablement deja au repos
#define ARRET_WIFI_LONG_MS  2000   // apres un refus avere : on attend vraiment

// Attendre que l'arret demande a la pile soit acte, au plus `maxMs`. Rend la
// main des l'evenement recu. idleTick() garde la LED, le bouton et
// l'aiguillage en vie pendant ce temps.
static void attendreArretWifi(unsigned long maxMs) {
  unsigned long t0 = millis();
  while (!arretWifiConfirme && millis() - t0 < maxMs) idleTick();
  // Plancher. L'evenement peut arriver en quelques millisecondes, or ce n'est
  // pas l'annonce de l'arret qui manquait historiquement mais le temps de se
  // ranger : le premier essai suit scanNets(), qui vient de couper la radio,
  // et partait en "association expiree" quand on le lancait trop tot. Sortir
  // au signal sans plancher supprimait la pause de 250 ms qui le protegeait.
  while (millis() - t0 < ARRET_WIFI_PLANCHER_MS) idleTick();
}



int indexScan(const char* ssid) {
  if (!scanDate || millis() - scanDate > SCAN_FRAIS_MS) return -1;
  for (uint8_t i = 0; i < netCount; i++)
    if (netSsid[i] == ssid) return i;
  return -1;
}


void demarrerConnexion(const char* ssid, const char* pass) {
  WiFi.mode(WIFI_STA);              // deja le cas en general : sans effet
  arretWifiConfirme = false;        // AVANT l'arret, sinon on lit celui d'avant
  WiFi.disconnect(false);           // false = la radio RESTE allumee
  attendreArretWifi(ARRET_WIFI_COURT_MS);
  derniereRaisonWifi = 0;           // APRES l'arret : notre propre depart ne compte pas
  // Le NOM, rien que le nom : c'est la carte qui choisit sa borne. Une version
  // precedente visait la meilleure borne du scan par son identifiant materiel
  // et son canal, pour eviter qu'elle ne s'adresse a la plus lointaine d'un
  // reseau maille. Mauvaise idee : viser une borne, c'est s'interdire toutes
  // les autres, et la pile repondait "reseau introuvable" au lieu d'essayer la
  // suivante. C'est le travail du pilote, pas le notre.
  if (WiFi.begin(ssid, pass) != WL_CONNECT_FAILED) return;

  // Refus : la pile n'avait pas fini de se ranger. Sans ce rattrapage, le
  // begin() etait perdu et l'essai brulait ses 4 a 12 s sur le reseau
  // PRECEDENT, sous le nom du suivant.
  Serial.println("[WiFi] configuration refusee (pile encore occupee), on attend l'arret");
  attendreArretWifi(ARRET_WIFI_LONG_MS);
  if (WiFi.begin(ssid, pass) != WL_CONNECT_FAILED) return;

  // Deuxieme refus : la pile ne se rangera pas toute seule, il ne sert a rien
  // de lui laisser plus de temps. Vu en conference, au log : apres un premier
  // essai en "authentification expiree", les essais 2 ET 3 se sont fait
  // refuser deux fois chacun. Seul le premier avait reellement emis ; les deux
  // autres n'ont jamais atteint leur reseau, et le terminal restait hors ligne
  // alors qu'un des trois aurait repondu.
  //
  // esp_wifi_disconnect() - WiFi.disconnect(false) - n'extrait pas une station
  // coincee en pleine poignee de main. Couper la radio, si : c'est pour ca que
  // b2d1a8c l'avait mis, et le retirer (5044de6) a ramene la panne. Elle reste
  // reservee a ce cas, le chemin doux suffisant pour un enchainement normal.
  Serial.println("[WiFi] refusee deux fois -> coupure de la radio");
  arretWifiConfirme = false;
  WiFi.disconnect(true);            // true = radio coupee : annule la tentative
  attendreArretWifi(ARRET_WIFI_LONG_MS);
  WiFi.mode(WIFI_STA);              // la radio revient en station
  // Au rallumage l'etage radio se recalibre : lui laisser le meme plancher
  // qu'apres un arret, sinon le begin() qui suit part dans la foulee.
  unsigned long t0 = millis();
  while (millis() - t0 < ARRET_WIFI_PLANCHER_MS) idleTick();
  if (WiFi.begin(ssid, pass) == WL_CONNECT_FAILED)
    Serial.println("[WiFi] refusee jusqu'apres la coupure : cet essai est perdu");
}


bool tryConnect(const char* ssid, const char* pass, unsigned long timeoutMs) {
  demarrerConnexion(ssid, pass);
  unsigned long t0 = millis();
  while (WiFi.status() != WL_CONNECTED && millis() - t0 < timeoutMs && !setupRequested) {
    idleTick();
  }
  if (WiFi.status() != WL_CONNECTED) return false;
  usedSsid = ssid; usedPass = pass;
  return true;
}

bool connectSaved() {
  prefs.begin(NVS_NS, true);
  String ssid = prefs.getString("ssid", "");
  String pass = prefs.getString("pass", "");
  prefs.end();
  if (!ssid.length()) return false;
  Serial.printf("[WiFi] reseau memorise : %s\n", ssid.c_str());
  return tryConnect(ssid.c_str(), pass.c_str(), WIFI_TRY_MS);
}

const char* stars(int8_t rssi) {
  if (rssi >= -55) return "****";
  if (rssi >= -67) return "***";
  if (rssi >= -78) return "**";
  return "*";
}

// Scan, puis trois regles qui rendent la liste lisible : les reseaux caches
// sont jetes, les bornes qui portent le MEME SSID sont fusionnees (sans quoi
// un reseau de salle occupe quatre lignes a lui seul), et le tout est trie par
// signal - les reseaux utilisables se retrouvent donc en page 1.
void scanNets() {
  netCount = 0;
  // Un scan lance alors qu'une tentative de connexion est encore en cours
  // renvoie un code NEGATIF (refuse), la boucle ci-dessous ne tourne pas et la
  // liste ressort vide : c'est ce qui faisait boucler le demarrage sans jamais
  // afficher l'ecran. On remet donc la radio au repos avant de scanner.
  WiFi.disconnect(true);
  WiFi.mode(WIFI_STA);
  delay(200);
  int n = WiFi.scanNetworks();
  if (n < 0) {                                 // deuxieme chance, un peu plus tard
    Serial.printf("[WiFi] scan refuse (%d), nouvelle tentative\n", n);
    delay(500);
    n = WiFi.scanNetworks();
  }
  if (n < 0) n = 0;
  for (int i = 0; i < n; i++) {
    String ssid = WiFi.SSID(i);
    if (!ssid.length()) continue;                        // reseau cache
    int8_t rssi = WiFi.RSSI(i);
    bool dup = false;
    for (uint8_t j = 0; j < netCount; j++) {
      if (netSsid[j] == ssid) {                          // meme reseau, autre borne
        if (rssi > netRssi[j]) netRssi[j] = rssi;         // on garde la plus forte
        netBornes[j]++;
        dup = true;
        break;
      }
    }
    if (dup) continue;
    if (netCount >= MAX_NETS) {                          // liste pleine : le
      uint8_t faible = 0;                                // nouveau ne rentre que
      for (uint8_t j = 1; j < netCount; j++)             // s'il bat le plus faible
        if (netRssi[j] < netRssi[faible]) faible = j;
      if (rssi <= netRssi[faible]) continue;
      netSsid[faible] = ssid; netRssi[faible] = rssi; netBornes[faible] = 1;
      continue;
    }
    netSsid[netCount] = ssid; netRssi[netCount] = rssi; netBornes[netCount] = 1;
    netCount++;
  }
  WiFi.scanDelete();
  scanDate = millis();
  // Tri par insertion. Les trois tableaux decrivent le MEME reseau a un index
  // donne : ils se deplacent ensemble, sinon un nom se retrouve avec le nombre
  // de bornes d'un autre.
  for (uint8_t i = 1; i < netCount; i++) {
    String ssid = netSsid[i]; int8_t rssi = netRssi[i]; uint8_t bornes = netBornes[i];
    int8_t j = i - 1;
    while (j >= 0 && netRssi[j] < rssi) {
      netSsid[j + 1] = netSsid[j]; netRssi[j + 1] = netRssi[j];
      netBornes[j + 1] = netBornes[j]; j--;
    }
    netSsid[j + 1] = ssid; netRssi[j + 1] = rssi; netBornes[j + 1] = bornes;
  }
  // La LISTE, pas seulement le compte. Sans elle, "3 reseaux distincts" ne dit
  // pas si celui qu'on cherche est la : impossible de distinguer un reseau hors
  // de portee d'un mot de passe refuse. Et quand la prise DIN n'est pas
  // branchee, l'ecran de configuration est invisible - le journal est alors la
  // seule fenetre sur ce que la carte voit reellement.
  Serial.printf("[WiFi] scan : %d entrees -> %u reseaux distincts\n", n, netCount);
  for (uint8_t i = 0; i < netCount; i++) {
    Serial.printf("        %-32s %4d dBm  %-4s %s\n", netSsid[i].c_str(), netRssi[i],
                  stars(netRssi[i]),
                  netBornes[i] > 1 ? "(plusieurs bornes : reseau maille)" : "");
  }
}

void showList(uint8_t page, uint8_t pages) {
  char buf[48];
  mnClear();
  mnLine(); mnLine("   MINITEL GPT - RESEAU WIFI"); mnLine();
  if (pages > 1) snprintf(buf, sizeof buf, "%u reseaux  -  page %u/%u", netCount, page + 1, pages);
  else           snprintf(buf, sizeof buf, "%u reseau%s", netCount, netCount > 1 ? "x" : "");
  mnLine(buf); mnLine();
  if (!netCount) {
    mnLine("Aucun reseau detecte.");
    mnLine("Approchez le Minitel d'une box,");
    mnLine("ou activez un partage de connexion.");
    mnLine();
  }
  for (uint8_t i = 0; i < PER_PAGE; i++) {
    uint8_t k = page * PER_PAGE + i;
    if (k >= netCount) break;
    snprintf(buf, sizeof buf, "%u %-24.24s %s", i + 1, netSsid[k].c_str(), stars(netRssi[k]));
    mnLine(buf);
  }
  mnLine();
  mnLine("Tapez le numero du reseau");
  if (pages > 1) mnLine("SUITE = page suivante");
  mnLine("R = reprendre la recherche");
  if (hasSaved()) mnLine("O = oublier le reseau memorise");
}

// Saisie du mot de passe. Le Minitel fait l'echo local des frappes : on ne
// reaffiche donc que l'effacement (BS espace BS), comme le fait le serveur.
// Retourne false si le visiteur revient a la liste ou ne tape plus rien.
bool askPassword(const String& ssid, String& out) {
  char buf[48];
  mnClear();
  mnLine(); mnLine("   MINITEL GPT - RESEAU WIFI"); mnLine();
  snprintf(buf, sizeof buf, "Reseau : %.28s", ssid.c_str());
  mnLine(buf); mnLine();
  mnLine("Mot de passe (affiche en clair) :");
  mnLine("(vide = reseau ouvert)");
  Minitel.print("> ");
  out = "";
  unsigned long last = millis();
  while (millis() - last < SETUP_IDLE_MS) {
    idleTick();
    uint8_t k = mnKey();
    if (!k) continue;
    last = millis();
    // Un mot de passe vide est valable : c'est un reseau ouvert, cas courant
    // des reseaux invites. Charge a tryConnect de dire si ca passe ou non.
    if (k == K_ENVOI_M) return true;
    if (k == K_SOM_M) return false;
    if (k == K_CORR_M) {
      if (out.length()) {
        out.remove(out.length() - 1);
        Minitel.write(0x08); Minitel.write(' '); Minitel.write(0x08);
      }
      continue;
    }
    if (k >= 0x20 && k <= 0x7E && out.length() < 63) out += (char) k;
  }
  return false;
}

// Ecran de configuration complet. Retourne true des qu'un reseau repond.
// false quand plus personne ne tape : l'appelant refait alors un tour des
// reseaux connus, pour qu'un boitier allume sans Minitel ne reste pas plante
// devant un menu que personne ne lit.
bool wifiSetupOnMinitel() {
  setupRequested = false;
  ouvrirFenetreAiguillage();      // on va ecrire sur le Minitel : il doit ecouter
  scanNets();
  // Meme sans un seul reseau detecte, on AFFICHE l'ecran : partir en silence,
  // c'etait laisser le visiteur devant un boitier qui clignote sans rien dire.
  // "R" relance la recherche, et le tour des reseaux connus reprend tout seul
  // au bout de SETUP_IDLE_MS.
  uint8_t page = 0;
  uint8_t pages = netCount ? (netCount + PER_PAGE - 1) / PER_PAGE : 1;
  showList(page, pages);
  unsigned long last = millis();
  while (millis() - last < SETUP_IDLE_MS) {
    idleTick();
    uint8_t k = mnKey();
    if (!k) continue;
    last = millis();
    if (k == K_SUITE_M) {                        // tourne en boucle : pas de
      page = (page + 1) % pages;                 // cul-de-sac, pas de touche
      showList(page, pages);                     // "page precedente" a coder
      continue;
    }
    if (k == 'R' || k == 'r') { scanNets(); page = 0;
      pages = (netCount + PER_PAGE - 1) / PER_PAGE; showList(page, pages); continue; }
    if (k == 'O' || k == 'o') { forgetSaved(); showList(page, pages); continue; }
    if (k < '1' || k > '9') continue;
    uint8_t idx = page * PER_PAGE + (k - '1');
    if (idx >= netCount) continue;
    String pass;
    if (!askPassword(netSsid[idx], pass)) { showList(page, pages); last = millis(); continue; }
    char buf[48];
    mnClear();
    mnLine(); mnLine("   MINITEL GPT - RESEAU WIFI"); mnLine();
    snprintf(buf, sizeof buf, "Connexion a %.24s...", netSsid[idx].c_str());
    mnLine(buf);
    if (tryConnect(netSsid[idx].c_str(), pass.c_str(), 20000)) {
      prefs.begin(NVS_NS, false);
      prefs.putString("ssid", netSsid[idx]);
      prefs.putString("pass", pass);
      prefs.end();
      mnLine();
      snprintf(buf, sizeof buf, "Connecte. IP %s", WiFi.localIP().toString().c_str());
      mnLine(buf); mnLine(); mnLine("Reseau memorise."); mnLine();
      mnLine("Demarrage du terminal...");
      delay(1500);
      return true;
    }
    mnLine(); mnLine("Echec : mot de passe refuse"); mnLine("ou reseau hors de portee.");
    delay(2500);
    showList(page, pages);
    last = millis();
  }
  return false;
}

// Essaie chaque reseau connu a tour de role. Retourne des le premier qui
// repond. La LED continue de clignoter pendant l'attente : sans moniteur
// serie, c'est le seul signe de vie.
bool connectKnown() {
  // Plusieurs passes sur la liste. Une association echoue par intermittence -
  // raison 4 sur un reseau qui passe au demarrage suivant, sans que rien n'ait
  // bouge - et un seul essai par reseau suffisait a basculer sur l'ecran de
  // configuration, c'est-a-dire a demander un mot de passe WiFi au visiteur
  // pour un raté passager. On repasse donc la liste, avec un releve neuf a
  // chaque tour : le scan coupe la radio et la laisse se ranger, ce qui fait
  // aussi office de pause entre deux tentatives.
  for (uint8_t passe = 1; passe <= WIFI_PASSES && !setupRequested; passe++) {
    if (passe > 1) {
      Serial.printf("[WiFi] aucun reseau connu n'a repondu, passe %u/%u\n",
                    passe, WIFI_PASSES);
      scanDate = 0;                        // forcer un nouveau releve
    }
    // Scanner d'abord pour ne pas perdre 12 s sur un reseau qui n'est meme pas
    // la - de retour a la maison, deux des trois entrees de secrets.h sont hors
    // de portee et coutaient 24 s a chaque demarrage. Un reseau absent du scan
    // reste essaye, mais brievement : il peut etre a SSID cache.
    if (millis() - scanDate > SCAN_FRAIS_MS || !scanDate) scanNets();
    // Les reseaux PRESENTS d'abord, les absents ensuite - l'ordre de
    // secrets.h ne decide plus de rien. En conference, les deux reseaux de la
    // maison etaient en tete de liste et passaient avant celui de la salle,
    // pourtant le seul a portee : deux echecs avant d'essayer le bon.
    for (uint8_t tour = 0; tour < 2; tour++) {
      for (uint8_t i = 0; i < KNOWN_COUNT; i++) {
        bool vu = indexScan(KNOWN_NETS[i].ssid) >= 0;
        if (vu != (tour == 0)) continue;
        Serial.printf("[WiFi] essai : %s%s\n",
                      KNOWN_NETS[i].ssid, vu ? "" : " (absent du scan, essai bref)");
        if (tryConnect(KNOWN_NETS[i].ssid, KNOWN_NETS[i].pass,
                       vu ? WIFI_TRY_MS : WIFI_TRY_ABSENT_MS)) return true;
        Serial.printf(" -> echec : %s (raison %u)\n",
                      raisonWifi(derniereRaisonWifi), derniereRaisonWifi);
      }
    }
  }
  return false;
}

void setup() {
  Serial.begin(115200);                       // console de debug (USB CDC sur C3)
  // USB CDC : le port n'est pret que ~1 s apres le boot. Sans cette attente,
  // les premiers messages sont perdus et le moniteur serie parait muet.
  unsigned long t0 = millis();
  while (!Serial && millis() - t0 < 2000) delay(10);
  Minitel.begin(1200, SERIAL_7E1, MINITEL_RX, MINITEL_TX);
  // Aiguillage des le demarrage. Une version precedente attendait d'avoir
  // quelque chose a afficher, pour ne pas deranger un Minitel deja en service.
  // Moins fiable a l'usage : le moment ou le terminal est le plus susceptible
  // d'ecouter est justement la mise sous tension, quand les deux appareils
  // demarrent ensemble. La fenetre est rouverte plus bas a chaque fois qu'on
  // s'apprete a ecrire - c'est sans effet s'il a deja bascule.
  ouvrirFenetreAiguillage();

  // Cause du dernier demarrage : distingue un redemarrage volontaire du filet
  // WiFi (SW) d'un plantage (PANIC), d'un watchdog, ou d'une alimentation qui
  // decroche (BROWNOUT) - ces derniers n'ont rien a voir avec le WiFi.
  const char* cause;
  switch (esp_reset_reason()) {
    case ESP_RST_POWERON:  cause = "mise sous tension";                    break;
    case ESP_RST_EXT:      cause = "bouton RESET";                         break;
    case ESP_RST_SW:       cause = "ESP.restart() (filet WiFi)";           break;
    case ESP_RST_PANIC:    cause = "PLANTAGE (exception)";                 break;
    case ESP_RST_INT_WDT:  cause = "WATCHDOG interruptions";               break;
    case ESP_RST_TASK_WDT: cause = "WATCHDOG tache";                       break;
    case ESP_RST_WDT:      cause = "WATCHDOG";                             break;
    case ESP_RST_BROWNOUT: cause = "BROWNOUT (alimentation insuffisante)"; break;
    case ESP_RST_DEEPSLEEP:cause = "sortie de veille profonde";            break;
    // Causes apparues avec les puces recentes. Sans elles, un reset par l'USB
    // (ce que fait esptool apres un televersement) ou, bien plus grave, une
    // CHUTE DE TENSION passagere se presentaient tous deux comme "inconnue" -
    // le diagnostic le plus utile confondu avec le plus banal.
    // PAS de #ifdef ici : ce sont des valeurs d'ENUMERATION, pas des macros.
    // #ifdef ne les voit pas, et les quatre cas etaient silencieusement
    // ignores par le preprocesseur - la cause restait "inconnue" alors meme
    // que le code semblait la traiter.
    case ESP_RST_USB:        cause = "peripherique USB (televersement)";    break;
    case ESP_RST_JTAG:       cause = "JTAG";                                break;
    case ESP_RST_PWR_GLITCH: cause = "CHUTE DE TENSION (alimentation !)";   break;
    case ESP_RST_CPU_LOCKUP: cause = "processeur bloque";                   break;
    default:               cause = "";                                    break;
  }
  if (*cause) Serial.printf("[BOOT] cause du dernier demarrage : %s\n", cause);
  else        Serial.printf("[BOOT] cause du dernier demarrage : inconnue (code %d)\n",
                            (int) esp_reset_reason());

  pinMode(STATUS_LED, OUTPUT);
  digitalWrite(STATUS_LED, LED_OFF);
  pinMode(BOOT_BTN, INPUT_PULLUP);            // lu seulement apres le boot
  WiFi.onEvent(onWifiEvent);                  // pour connaitre la raison des echecs
  // L'adresse MAC de la carte. Sans elle, impossible de verifier si la box la
  // bloque : un filtrage MAC ou un "controle d'acces" fait expirer
  // l'authentification (raison 2) sans jamais rien refuser explicitement - le
  // point d'acces se contente d'ignorer un inconnu. C'est aussi ce qu'il faut
  // chercher dans la liste des appareils de la box.
  WiFi.mode(WIFI_STA);
  Serial.printf("[WiFi] adresse MAC de cette carte : %s\n", WiFi.macAddress().c_str());

#if DEBUG_UART
  // Test du sens ESP32 -> Minitel, independant du WiFi et du serveur : on
  // efface l'ecran et on ecrit une ligne. Si elle s'affiche, la moitie
  // descendante de la liaison (GPIO5 -> shifter -> DIN 1) est bonne.
  Serial.println("[UART] DEBUG_UART actif : envoi du motif de test au Minitel");
  Minitel.write(0x0C);                        // FF : effacement de l'ecran
  Minitel.print("TEST ESP32 OK");
  Minitel.write(0x0D); Minitel.write(0x0A);   // CR LF
#endif

  // Reseau memorise d'abord (il a ete choisi ici meme, sur place), puis la
  // liste de secrets.h. Si rien ne repond, on demande au visiteur sur l'ecran
  // du Minitel - et s'il ne repond pas, on refait un tour tout seul : le
  // boitier peut tres bien etre allume avant la box, ou sans Minitel branche.
  while (true) {
    if (setupRequested) {                     // appui bref sur BOOT : on ouvre
      if (wifiSetupOnMinitel()) break;        // l'ecran sans finir le tour
      continue;
    }
    if (connectSaved() || connectKnown()) break;
    Serial.println("[WiFi] aucun reseau connu n'a repondu -> configuration");
    if (wifiSetupOnMinitel()) break;
  }
  Serial.printf("[WiFi] OK sur %s, IP %s\n", WiFi.SSID().c_str(),
                WiFi.localIP().toString().c_str());
  ouvrirFenetreAiguillage();      // le terminal va servir : on peut l'aiguiller
  // On n'affiche PAS WS_PATH en entier : il contient le token.
  Serial.printf("[WS] cible : %s:%d%s?token=***\n", WS_HOST, WS_PORT, WS_ENDPOINT);

#if USE_LOCAL
  // ws:// en clair : parfait pour tester sur le reseau local.
  webSocket.begin(WS_HOST, WS_PORT, WS_PATH);
#else
  // wss:// -> beginSSL. Traefik/Coolify presente un vrai cert Let's Encrypt.
  // Pour durcir ensuite : webSocket.setSSLFingerprint(...).
  webSocket.beginSSL(WS_HOST, WS_PORT, WS_PATH);
#endif
  webSocket.onEvent(onWsEvent);
  webSocket.setReconnectInterval(3000);       // reconnexion auto
  // Ping applicatif : detecte un lien mort en ~30 s au lieu d'attendre que
  // TCP s'en apercoive (ping 15 s, pong attendu sous 3 s, 2 echecs tolerees).
  webSocket.enableHeartbeat(15000, 3000, 2);
}

void loop() {
  webSocket.loop();
  updateStatusLed();
  checkResetButton();                         // apres la LED : l'appui la fige
  maybeForceModePeriInformatique();
  maybeReveilMinitel();
  // Appui bref alors que tout va bien : sans effet, mais on l'oublie pour
  // qu'il ne surgisse pas au prochain passage par la configuration.
  if (setupRequested) {
    setupRequested = false;
    Serial.println("[BOOT] appui bref ignore : deja connecte");
  }

#if DEBUG_UART >= 2
  // Emission periodique du motif de test : donne un signal permanent a sonder
  // sur la ligne TX, et fait defiler des [RX] en continu si GPIO4 et GPIO5
  // sont relies (bouclage).
  static unsigned long lastTest = 0;
  if (millis() - lastTest > 2000) {
    lastTest = millis();
    Minitel.print("TEST ESP32 OK");
    Minitel.write(0x0D); Minitel.write(0x0A);
  }
#endif

  // Filet WiFi : l'auto-reconnexion du core couvre les coupures ordinaires
  // (box qui redemarre, hors de portee), mais PAS les raisons AUTH_FAIL ou
  // ASSOC_LEAVE, qui laisseraient la carte morte jusqu'a un reset physique.
  static unsigned long wifiDownSince = 0;
  static bool wifiRetried = false;
  if (WiFi.status() != WL_CONNECTED) {
    if (wifiDownSince == 0) {
      wifiDownSince = millis();
      wifiRetried = false;
      Serial.println("[WiFi] perdu, attente de la reconnexion automatique");
    } else if (!wifiRetried && millis() - wifiDownSince > 30000) {
      // L'auto-reconnexion du core peut s'enliser : on la relance une fois
      // explicitement avant d'envisager le redemarrage.
      wifiRetried = true;
      Serial.println("[WiFi] 30 s sans reseau -> relance de la connexion");
      demarrerConnexion(usedSsid.c_str(), usedPass.c_str());
    } else if (millis() - wifiDownSince > 120000) {
      // Le redemarrage refait le tour complet de la liste, ce que la relance
      // ci-dessus ne fait pas : c'est ainsi qu'on bascule sur le reseau de
      // secours quand le reseau habituel disparait pour de bon.
      Serial.println("[WiFi] 2 min sans reseau -> redemarrage");
      Serial.flush();
      ESP.restart();
    }
  } else {
    if (wifiDownSince != 0) {
      Serial.printf("[WiFi] retabli apres %lu s\n",
                    (millis() - wifiDownSince) / 1000);
    }
    wifiDownSince = 0;
  }

  // Minitel -> serveur : on lit le clavier et on empile
  while (Minitel.available()) {
    uint8_t b = (uint8_t) Minitel.read();
#if DEBUG_UART
    Serial.printf("[RX] 0x%02X %c\n", b, (b >= 32 && b < 127) ? (char) b : '.');
#endif
    if (txLen < sizeof(txBuf)) txBuf[txLen++] = b;
    lastByteMs = millis();
    if (txLen >= sizeof(txBuf)) flushTx();     // tampon plein -> envoi
  }
  // envoi si le tampon "repose" depuis 15 ms (fin de rafale de frappe)
  if (txLen > 0 && (millis() - lastByteMs) > 15) flushTx();
}
