omarquet/minitel-gpt/(commit log)

2026-06-02 feat: initial commit — MinitelGPT
    Terminal ChatGPT sur Minitel Telic MB1 via Raspberry Pi Zero 2 W.
    Services : wifi-manager (hotspot IoT), boot-notify (email IP), minitel-chatgpt (Claude).
    UART PL011 1200 baud 7E1, level shifter BSS138.
2026-06-02 fix: migration OpenAI→Claude, email Resend via onboarding@resend.dev
    - minitel_chatgpt.py : switch vers anthropic SDK (claude-haiku-4-5)
    - boot_notify.py : User-Agent + FROM configurable via RESEND_FROM
    - wifi_manager.py : hotspot nmcli + Flask UI provisioning
    - config/env.example : mis à jour avec ANTHROPIC_KEY + CLAUDE_MODEL
2026-06-02 feat: animation portrait Jim style Mitterrand 1981
    - jim_ascii.py : portrait ASCII 40x20 généré depuis jim.jpg (Pillow)
    - jim_animation.py : révélation progressive à 1200 baud — effet naturel
    Intro au démarrage (attend Entrée), interlude sur SOMMAIRE
    - minitel_chatgpt.py : animation intégrée avant et pendant la session
    - tools/generate_ascii.py : script pour régénérer depuis une nouvelle photo
2026-06-04 feat: portrait jim2.jpg — N&B fond blanc, meilleure lisibilité ASCII
2026-06-12 feat: admin UI étendue — presets dynamiques, génération IA, clé Anthropic
    - admin_ui.py : création/suppression de presets, textes personnalisables
    (titre/invite/attente), générateur de prompt système par IA, saisie clé
    Anthropic dans .env, bouton "Redémarrer le terminal"
    - minitel_chatgpt.py : textes d'accueil lus depuis le preset, rechargés au sommaire
    - prompts.json : champs title_msg/question_msg/loading_msg par preset
    - sudoers : NOPASSWD systemctl restart pour l'admin web
2026-06-12 feat: wifi-manager en surveillance continue (auto-hotspot)
    Transforme le wifi-manager de oneshot en service permanent :
    - surveille la connexion toutes les 30s
    - bascule automatiquement en hotspot MinitelGPT-Setup après ~2 min
    de déconnexion (plus besoin de rebooter dans un lieu inconnu)
    - portail web de config WiFi accessible en permanence (port 80),
    via le hotspot OU le réseau local
    - coupe le hotspot dès qu'une connexion est rétablie
    Corrige le blocage vécu en déplacement : le Pi expose désormais
    toujours un moyen de le reconfigurer.
2026-06-12 fix: portail wifi complet — captive portal, UX confirmation, connexion fiable
    - monitor_loop : distingue connexion client réelle vs hotspot (client_connected),
    ne coupe plus son propre hotspot (wlan0 a 192.168.4.1 en mode AP)
    - captive portal : redirection DNS wildcard (dnsmasq-shared.d) + sondes OS
    → le portail s'ouvre automatiquement à la connexion au hotspot
    - /connect : confirmation affichée immédiatement avant la bascule réseau
    (le client perd le hotspot, ne peut pas recevoir la réponse après)
    - connect_wifi : suppression des profils par SSID (pas par nom) + création
    explicite avec wifi-sec.key-mgmt wpa-psk → corrige "key-mgmt missing"
    - outils de test : sim_wifi,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
2026-06-12 refactor: UI admin réorganisée + couleurs du logo
    - logo centré et agrandi en haut de page
    - section unique 'Personnalité' : le sélecteur charge dynamiquement les
    champs du preset choisi (JS), boutons Enregistrer/Activer/Supprimer + Nouveau
    - section 'Paramètres' à part : clé Anthropic + email regroupés
    - palette turquoise menthe du logo (#4ecdc4) sur les boutons et accents
2026-06-17 chore: retrait des fichiers du portrait Videotex (fonctionnalité abandonnée)
2026-06-17 chore: mot de passe admin 13100 → mistral
2026-06-17 docs: README + install.sh à jour (Mistral, sans Resend, SD/push code)
    - install.sh : pyfiglet au lieu d'anthropic, dnsmasq-base/iw, désactivation
    dnsmasq système, sudoers, services minitel-chatgpt/wifi-manager/admin-ui
    (boot-notify retiré)
    - README : Mistral, préparation carte SD (Pi Imager), procédure git pull pour
    les mises à jour, fichiers de connaissance, IP via touche Guide
2026-06-19 docs: note de compatibilité Pi Zero W (v1) en cas de pénurie de Zero 2 W
2026-06-19 fix: retire la commande PRO2 de clear() qui cassait les touches du Minitel 1
    La commande de forçage Vidéotex « ESC : 2 ~ » (1B 3A 32 7E) envoyée à
    chaque effacement faisait basculer le Minitel 1 hors du mode Vidéotex :
    les touches de fonction n'étaient plus émises en SEP et le service ne
    les reconnaissait plus (l'alphabet ASCII passait toujours).
    En mode recommandé (Fnct+Sommaire), Minitel 1 et 2 sont en Vidéotex
    natif avec touches SEP standard : cette commande était inutile. La
    reconnaissance des touches VT100 (SS3 « ESC O x ») reste en place dans
    read_key au cas où Fnct+T A serait utilisé sur un Minitel 2.
2026-06-19 docs: corrige la note (plus de forçage Vidéotex dans clear)
2026-06-20 feat(admin): mise à jour de l'application depuis l'interface web (git)
    - Onglet Paramètres : bouton « Vérifier les mises à jour » (git fetch +
    changelog), « Mettre à jour maintenant » (git reset --hard origin/main +
    redémarrage des services), et rollback vers la version précédente.
    - prompts.json devient local (gitignoré) : renommé en prompts.default.json
    dans le dépôt, recopié au 1er lancement si absent. Une mise à jour
    n'écrase donc jamais les personnalités éditées dans l'admin (ni .env,
    ni les fichiers de connaissance).
    - admin-ui se redémarre de façon détachée pour que la réponse HTTP parte.
2026-06-20 docs: procédure d'installation complète et à jour
    install.sh :
    - ajoute git (requis pour la mise à jour depuis l'admin)
    - initialise config/prompts.json depuis prompts.default.json s'il manque
    - commentaires sur chaque dépendance, notes finales corrigées (câblage
    3 fils, rituel Minitel 2 = Fnct+Sommaire, mise à jour via l'admin)
    README : section Installation alignée (git, prompts.json, clone git,
    update en un clic depuis l'admin).
2026-06-21 feat(admin): lien de création de clé API Mistral (admin.mistral.ai)
2026-06-25 docs: lien clé Claude vers platform.claude.com + intro multi-fournisseur
    Aligne le lien de création de clé Claude sur https://platform.claude.com/
    (admin + README) et précise dans l'intro du README que l'IA est au choix
    Mistral ou Claude.
2026-06-27 fix(install): pip absent sur Pi OS Lite bloquait l'install des paquets Python
    Sur une image fraîche, `python3 -m pip` n'existe pas → "No module named pip"
    et set -e interrompait l'installation à l'étape [2/7]. pyfiglet est désormais
    installé via apt (python3-pyfiglet), avec pip en repli (python3-pip ajouté aux
    paquets système).
2026-06-27 fix(terminal): ne plus crasher si le fichier de log est inaccessible
    Un fichier logs/chatgpt.log appartenant à root (créé par un lancement sudo de
    test) provoquait une PermissionError fatale au démarrage -> boucle de crash et
    écran Minitel vide. Le FileHandler est désormais optionnel (try/except) : si le
    fichier n'est pas ouvrable, on bascule sur la sortie standard (journald) au lieu
    de tuer le service. Chemin de log rendu relatif au projet.
2026-07-04 Deploiement VPS Coolify : bridge WebSocket ESP32 + Docker
2026-07-04 feat(server): ajout support Gemini, écrans echo/tests WS, préréglage annees80bis
    - server.py : endpoints /ws-echo et /ws-gemini pour tester la chaîne WS sans
    passer par la boucle de chat complète, plus call_gemini() (LLM_PROVIDER=gemini)
    - docker-compose.yml : variables GEMINI_KEY/GEMINI_MODEL, port 8080 fixe (au
    lieu d'un port éphémère) pour faciliter les tests locaux
    - config/prompts.default.json : nouveau préréglage "annees80bis" (garde-fou
    anti prompt-injection renforcé), actif par défaut
    - minitel-test.html : client de test navigateur pour /ws (échappement HTML
    des caractères reçus pour éviter une injection XSS)
    - suppression de minitel-emulator.html (remplacé p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
2026-07-04 chore: versionner .claude/settings.json, ignorer seulement settings.local.json
    settings.json ne contient qu'une allowlist de permissions (rien de
    sensible/machine-specific) - suit la convention Claude Code où seul
    settings.local.json (config perso) est ignoré.
2026-07-05 docs: mettre à jour CLAUDE.md et DEPLOY.md après minitel-test.html et Gemini
    - remplace les références à minitel-emulator.html (supprimé) par minitel-test.html
    - documente le support Gemini (LLM_PROVIDER=gemini, GEMINI_KEY/GEMINI_MODEL)
    et les endpoints de test /ws-echo, /ws-gemini
    - coche "fichiers poussés sur le fork" dans le statut
2026-07-05 fix(docker): installer curl pour le healthcheck Coolify
    Le healthcheck Coolify (GET /healthz depuis l'intérieur du conteneur)
    échouait avec "curl: not found" / "wget: not found" - l'image slim
    n'embarque aucun des deux. Ajoute curl (nécessite aussi de corriger le
    port du healthcheck sur 8080 côté config Coolify, actuellement sur 3000).
2026-07-05 fix(docker): stubs systemctl/sudo pour éviter le crash de l'admin en conteneur
    admin_ui.py (fichier d'origine, conçu pour un Pi avec systemd) appelle
    systemctl/sudo sans gérer leur absence. En conteneur ces binaires
    n'existent pas -> FileNotFoundError -> 500 sur la page d'accueil.
    Stubs no-op ajoutés dans l'image (systemctl is-active répond "inactive",
    sudo exécute directement la commande) : les boutons restart restent
    inertes comme déjà documenté, mais l'admin ne plante plus.
2026-07-05 docs: ajouter .env.example
    Liste toutes les variables d'environnement utilisées (LLM_PROVIDER,
    clés/modèles Mistral/Claude/Gemini, admin) avec des valeurs par défaut
    ou vides, sans secret.
2026-07-05 fix(server): servir minitel-test.html (route manquante, 404)
    Le fichier n'avait pas de route Flask, contrairement aux autres pages
    de test - impossible d'y accéder via l'URL publique.
2026-07-05 feat(security): protéger /ws, /ws-echo, /ws-gemini par un jeton partagé
    Sans authentification, n'importe qui connaissant l'URL publique pouvait
    discuter avec l'assistant et consommer la clé API (Mistral/Claude/Gemini).
    - server.py : WS_TOKEN (env var) requis en ?token=... si configuré ;
    vide par défaut = comportement inchangé (pratique en dev local)
    - docker-compose.yml, .env.example, CLAUDE.md, DEPLOY.md : documentation
    de la nouvelle variable
    - firmware/minitel_esp32_bridge.ino : WS_PATH inclut le token à configurer
    - minitel-test.html : champ token dédié, ajouté à l'URL de connexion
2026-07-05 feat(prompts): annees80bis raisonne avec la date du jour réelle (en 1989)
    Ajoute une règle 8 : dès qu'il a besoin de la date du jour (question
    directe ou raisonnement sur une info qui en dépend), le jour/mois réels
    sont utilisés, mais toujours ramenés à l'année 1989.
2026-07-05 fix(prompts): injecter la vraie date du jour (ramenée à fixed_year)
    Un LLM ne connaît pas la date du jour par lui-même - lui dire dans le
    prompt "utilise le jour/mois réels" ne suffit pas, il invente une date
    plausible mais fausse (constaté : "23 mai 1989" au lieu d'aujourd'hui).
    - server.py : with_fixed_date() calcule le jour/mois réels côté serveur
    et les injecte dans le system prompt, ramenés à l'année du champ
    optionnel "fixed_year" du preset actif (lu directement dans
    prompts.json, sans toucher minitel_chatgpt.py)
    - prompts.default.json : fixed_year=1989 sur le preset annees80bis
2026-07-05 fix(prompts): fallback fixed_year par nom de preset
    Le prompts.json déjà déployé sur le volume Coolify n'a pas le champ
    fixed_year (seul prompts.default.json, relu au premier boot, l'a).
    Fallback sur le nom du preset actif pour que la correction s'applique
    sans devoir éditer le fichier sur le volume à la main.
2026-07-05 feat(prompts): annees80bis "prédit" la conférence Agile en Seine 2026
    Ajoute une règle 9 (exception "don de prédiction") au preset : il connaît
    l'existence de la conférence (dates, lieu), mais renvoie systématiquement
    vers l'URL officielle du programme plutôt que de citer des sessions -
    celles-ci peuvent encore changer jusqu'au dernier moment.
2026-07-05 feat(server): accès web live pour Agile en Seine 2026 uniquement
    Aucun des fournisseurs LLM (Mistral/Claude/Gemini) n'a la recherche web
    activée dans les appels API de ce projet - sans ça, le modèle ne peut
    que réciter un texte figé qui deviendrait vite obsolète.
    Exception unique et en dur : si la question mentionne "Agile en Seine",
    le serveur récupère lui-même la page du programme (requests.get, extrait
    nettoyé des <script>/<style>) et l'injecte dans le prompt pour cette
    réponse uniquement - pas de tool-calling générique, juste ce cas précis.
2026-07-05 fix(security): ne plus afficher le mot de passe admin sur l'écran GUIDE
    show_guide_ws() copiait le comportement du Pi d'origine (mot de passe
    affiché en clair), pertinent quand seul le foyer a un accès physique au
    Minitel. Sur le VPS, /ws est public : n'importe qui pouvait obtenir le
    mot de passe admin juste en appuyant sur GUIDE.
2026-07-05 feat(server): activer ANNULATION (efface la ligne) et REPETITION (redit)
    Ces deux touches étaient définies mais jamais gérées dans le code
    d'origine (silencieusement ignorées). Ajoute read_question_ws(), une
    copie de read_question() de minitel_chatgpt.py étendue pour :
    - ANNULATION : efface toute la phrase en cours de saisie (pas juste un
    caractère comme RETOUR/CORRECTION)
    - REPETITION : réaffiche le dernier message de l'assistant sans relancer
    d'appel LLM
    Duplique la logique plutôt que de toucher minitel_chatgpt.py.
2026-07-05 chore: supprimer les images en double à la racine
    Doublons morts des mêmes fichiers dans assets/, qui sont les seuls
    réellement servis (admin_ui.py ne référence que /assets/...). Aucune
    route ne sert la racine du dépôt.
2026-07-05 chore: supprimer les fichiers orphelins restants
    - config/dnsmasq-shared-captive.conf, tools/safety_net.py,
    tools/test_hotspot.py, tools/sim_wifi.py : jamais référencés par
    aucun script ni la doc
    - server.py : retire les 4 routes mortes pointant vers des HTML
    supprimés du disque (minitel-emulator.html/.minimal/.simple,
    minitel-echo-test.html) ; corrige la référence obsolète dans le
    docstring vers minitel-test.html
2026-07-05 feat!: retirer le support Raspberry Pi, consolider Gemini
    Suppression complète du montage Pi + port série d'origine, devenu
    inutile depuis le passage à l'ESP32/VPS :
    - install.sh, unités systemd (admin-ui/minitel-chatgpt/wifi-manager),
    minitel-gpt-sudoers, config/env.example
    - services/minitel_serial.py, services/wifi_manager.py,
    services/test_uart.py
    minitel_chatgpt.py (fichier d'origine) est nettoyé de tout ce qui était
    spécifique au Pi : import serial, détection de port, classe Term,
    get_ip(), show_guide() et run() (boucle principale sur port série).
    read_question() récupère au passage le support ANNULATION/REPETITION
    qui vivait en double dans server.py (read_question_ws s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
2026-07-05 docs: réécrire README.md pour VPS/ESP32, mettre à jour CLAUDE.md/DEPLOY.md
    README.md décrivait presque exclusivement le montage Raspberry Pi
    d'origine (câblage FTDI, install.sh, imaging Pi OS) - entièrement
    réécrit pour la chaîne ESP32 -> Coolify de ce fork : déploiement,
    sécurité (WS_TOKEN, écran GUIDE), matériel ESP32, touches du Minitel,
    dépannage.
    DEPLOY.md : simplifie les étapes 1-2 (le fork existe déjà, plus besoin
    de décrire le bootstrap initial depuis l'upstream), ajoute le piège du
    port de healthcheck Coolify (défaut 3000 au lieu de 8080 -> 502).
    CLAUDE.md : documente le retrait du support Pi et la consolidation
    Gemini.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
2026-07-05 refactor(prompts): renommer system -> prompt, system_file -> prompt_file
    Renommage du champ de données (schéma prompts.json/prompts.default.json)
    et de tout ce qui le lit/l'écrit - formulaire admin, JS inline,
    minitel_chatgpt.py. Les usages du mot "system" propres au protocole des
    API LLM (rôle "system" OpenAI-style, paramètre "system" d'Anthropic)
    restent inchangés, ce sont des contrats externes sans rapport avec notre
    schéma.
    Tous les presets (annees80, annees80bis, assistant_general, guide_paris)
    migrés vers prompt_file : chaque prompt vit maintenant dans son propre
    fichier texte sous config/prompts/, avec de vrais retours à la ligne au
    lieu d'une chaîne JSON échappée sur une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
2026-07-05 refactor: renomme minitel_chatgpt.py en minitel_gpt.py, nettoie l'admin web
    - services/minitel_chatgpt.py -> services/minitel_gpt.py, imports mis à jour
    dans server.py, doc (CLAUDE.md, README.md) alignée
    - admin_ui.py : retire tout ce qui ne sert plus à rien en conteneur Docker
    (bloc "État du Pi" avec IP/statut systemd factices, bouton restart no-op,
    mécanisme de mise à jour git check/update/rollback incompatible avec le
    modèle de déploiement Coolify). Les messages de sauvegarde (prompts, LLM)
    ne prétendent plus faussement redémarrer le terminal.
    - server.py : la touche GUIDE permet maintenant de choisir la personnalité
    active directement depuis le Minitel (liste numé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
2026-07-05 feat(display): empêcher le Markdown dans les réponses (Minitel = texte brut)
    Le Minitel ne sait afficher que du texte brut - un LLM qui répond avec
    **gras**, # titres ou des listes à puces Markdown afficherait les
    symboles bruts à l'écran.
    - minitel_gpt.py : load_preset() ajoute une consigne systématique
    interdisant le Markdown à la fin du prompt (quel que soit le preset,
    pas besoin d'éditer chaque fichier .txt) ; strip_markdown() en filet
    de sécurité côté code si le LLM en génère quand même (gras, italique,
    code inline, titres, liens)
    - server.py : appliqué sur les réponses du terminal principal et de
    l'endpoint de test /ws-gemini
    - admin_ui.py : même consigne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
2026-07-05 feat(display): couleur et double taille pour les réponses du LLM
    Convention légère {rouge}...{/}, {grand}...{/} (etc.) traduite en vrais
    codes Videotex ESC, pour que le LLM puisse mettre en évidence un mot ou
    une phrase clé sans passer par du Markdown que le Minitel ne sait pas
    afficher.
    - minitel_gpt.py : corrige au passage des constantes de taille de
    caractère mal étiquetées dans le code d'origine (DBL_HEIGHT pointait
    vers le code "taille normale" 0x4C au lieu de 0x4D - vérifié auprès de
    la norme Videotex), ajoute FG_RED/FG_BLUE/FG_MAGENTA/FG_BLACK,
    MINITEL_MARKUP_TAGS + apply_minitel_markup(), et l'instruction
    correspondante dans load_preset(). wrap() devient conscie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
2026-07-05 style: relooker minitel-test.html façon vrai boitier Minitel
    Recherche rapide sur l'apparence du Minitel 1B Telic/Alcatel (boitier
    plastique beige, écran encadré d'un bezel sombre, touches de fonction
    distinctement colorées - Envoi en vert, confirmé par plusieurs sources).
    - boitier beige arrondi avec bandeau clavier
    - écran avec bezel sombre + léger effet scanlines/vignette CRT
    - touches de fonction en grille 4 colonnes, couleurs distinctes par
    touche (gris pour la plupart, bleu Guide, orange Suite, vert Envoi)
    - barre d'outils de test (URL/token/connexion) détachée visuellement,
    clairement identifiable comme un ajout de dev et non une pièce du
    boitier
    Aucun changement de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
2026-07-05 fix(minitel-test): corrige le chevauchement des caractères en grande taille
    transform:scale() par caractère ne réservait pas d'espace supplémentaire
    dans la mise en page, donc les caractères en {grand}/double taille se
    chevauchaient (rapporté par capture d'écran). Remplacé par un regroupement
    des caractères consécutifs de même couleur/taille en un seul <span>, avec
    font-size (hauteur) et letter-spacing (largeur) qui réservent correctement
    l'espace nécessaire - vérifié avec capture d'écran headless Chrome.
    Au passage :
    - teinte du boîtier plus proche du beige RAL 1001 (référence électronique
    80s), bandeau clavier assorti
    - indicateur de connexion : pastille colorée (ve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
2026-07-05 feat(pagination): RETOUR revient sur une page précédente
    show_response() bouclait avec un simple for (avance uniquement). Passage
    à un while avec index de page mutable : RETOUR décrémente l'index et
    réaffiche la page précédente (autant de fois que nécessaire pendant la
    lecture d'une réponse multi-pages), sans effet sur la première page.
    Testé (avance/recul/plusieurs pages en arrière/SOMMAIRE en cours de
    route/réponse sur une seule page).
2026-07-05 fix(minitel-test): URL sur sa propre ligne, police Courier New
    L'URL wss:// n'avait pas assez de place à côté du champ token, illisible
    dès qu'elle dépassait quelques caractères. Devbar réorganisée en deux
    lignes explicites (URL+connexion / token+effacer+statut) au lieu de
    compter sur le flex-wrap.
    Police du body/écran : Courier New en priorité (au lieu de ui-monospace,
    qui varie selon l'OS) - plus proche du rendu terminal, et plus fiable
    pour juger visuellement la limite des 40 colonnes.
2026-07-05 fix(display): wrap() ne comptait pas la double largeur comme 2 colonnes
    Bug confirmé par capture d'écran : un titre en {grand} débordait très
    largement au-delà des 40 colonnes. Sur le vrai Minitel, un caractère en
    double largeur (ESC 0x4E/0x4F) occupe 2 des 40 colonnes, pas 1 - donc
    une ligne en {grand} ne peut contenir que ~20 caractères, pas 40.
    visible_len()/visible_truncate() suivent maintenant l'état de taille en
    cours (1 ou 2 colonnes par caractère) au lieu de compter chaque
    caractère pour 1. wrap() mesure aussi la ligne candidate d'un seul
    tenant (plutôt que cur et word séparément) pour que cet état se
    propage correctement d'un mot au suivant.
    Testé : le découpage re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
2026-07-05 fix(minitel-test): aligner les colonnes de la barre d'outils
    Les deux lignes (URL/connexion et token/effacer/statut) utilisaient
    chacune leur propre flex-wrap, donc les boutons ne s'alignaient pas
    d'une ligne à l'autre. Passage à une grille CSS (grid-template-columns)
    partagée par les deux lignes (display:contents sur les wrappers) : les
    colonnes s'alignent maintenant automatiquement sur la largeur du
    contenu le plus large de chaque colonne.
2026-07-05 fix(pagination): RETOUR fonctionne aussi après la dernière page
    Rapporté : sur la dernière page d'une réponse multi-pages (où seul
    SOMMAIRE était proposé), RETOUR ne faisait rien. En cause : une fois la
    dernière page affichée, show_response() rendait la main immédiatement
    à read_question() - et RETOUR y était un no-op quand la saisie est vide.
    - read_question() : RETOUR sur saisie vide renvoie une nouvelle action
    'retour' au lieu de ne rien faire (CORRECTION reste un pur backspace,
    dissocié de RETOUR qui a ce double rôle contextuel)
    - show_response(start_at_last=True) : mode révision qui démarre sur la
    dernière page et attend une touche même là (au lieu de rendre l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
2026-07-05 fix(input): accents non tronqués + echo sur la bonne ligne
    Deux bugs rapportés en testant "actualité du monde" :
    1. server.py WSTerm.read_byte() : le message reçu était encodé en ASCII
    avec errors="ignore", qui supprime silencieusement les caractères
    accentués ("actualité" → "actualit"). Passe par to_ascii() (même
    translittération que pour les réponses du LLM) avant l'encodage ASCII,
    pour obtenir "actualite" au lieu de tronquer.
    2. minitel-test.html sendNow() : un feed([CR, LF]) avant l'echo du texte
    tapé le faisait apparaître sur la ligne suivante au lieu d'être mis à
    la suite du "> ". Retiré - le texte s'affiche maintenant juste après
    le prompt, c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
2026-07-05 fix: hauteur d'écran fixe + chevrons qui s'accumulaient sur RETOUR
    - minitel-test.html : .screen utilisait min-height, qui grandissait avec
    les lignes en {grand}/double hauteur (font-size plus grand). Un vrai
    Minitel a un écran de taille physique fixe quel que soit le texte.
    Remplacé par une hauteur fixe calculée pour 25 lignes - vérifié
    identique (461.5px) avec et sans texte en {grand}.
    - server.py : RETOUR (ou REPETITION) appuyé sans aucune réponse à revoir
    faisait un `continue` direct vers read_question(), qui réaffiche "> "
    sans jamais passer à la ligne - le prompt s'accolait au précédent à
    chaque appui ("> > > > ..."). Ajout d'un saut de ligne avant de boucl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
2026-07-05 style(minitel-test): couleurs des touches de fonction fidèles à l'original
    Photo de référence d'un vrai clavier Minitel Telic/Alcatel : toutes les
    touches de fonction (Sommaire, Annulation, Retour, Correction,
    Répétition, Guide, Suite) sont dans la même teinte terracotta/brique -
    pas de bleu pour Guide comme précédemment. Seul Envoi reste vert.
2026-07-05 fix(pagination): RETOUR montre directement autre chose, pas la dernière page
    Rapporté : après une réponse, RETOUR rouvrait la dernière page (déjà
    lue) et il fallait appuyer sur SUITE juste pour revenir au prompt de
    saisie - une étape qui ne servait à rien. En cause : le mode révision
    démarrait sur la dernière page (start_at_last).
    Démarre maintenant sur l'avant-dernière page directement - RETOUR
    montre tout de suite un contenu différent de ce qu'on vient de lire.
    Naviguer explicitement jusqu'à la dernière page (via SUITE) demande
    toujours un SUITE de plus pour en sortir, ce qui reste logique puisque
    c'est un choix délibéré à ce stade.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
2026-07-05 fix + chore: écran non effacé après révision, retrait des mentions Coolify
    - server.py : après une révision (RETOUR/REPETITION), l'écran n'était
    pas effacé avant d'afficher "Repondez ou SOMMAIRE pour finir" - le
    texte s'ajoutait sous les indications "SUITE pour continuer"/"RETOUR
    pour la page precedente" au lieu de les remplacer. Repro confirmée par
    capture d'écran sur le déploiement réel. Ajout du t.clear() manquant.
    - Retrait de toutes les mentions de "Coolify" (doc + commentaires code) :
    généralisées en "serveur"/"reverse proxy", le projet ne dépend d'aucun
    hébergeur particulier.
2026-07-05 docs(hardware): câblage détaillé (alim broche 5, brochage DIN non séquentiel)
    Retour d'expérience sur un montage réel (Minitel 1B Matra, carte VGP5) :
    - la broche 5 du DIN peut alimenter l'ESP32 (~8,5-13V -> buck converter
    5V -> VIN ESP32 + côté HV du level shifter), au lieu du simple "ne pas
    toucher" générique - évite une alimentation externe séparée
    - le brochage physique du connecteur DIN-5 n'est pas séquentiel :
    1-4-2-5-3 de gauche à droite vu de face, pas 1-2-3-4-5 - piège classique
    de câblage
    Mis à jour dans le firmware (.ino) et le README.
2026-07-05 docs(hardware): précise VGP5 vs VGP2 pour l'alimentation broche 5
    L'alimentation disponible sur la broche 5 du DIN dépend du circuit vidéo
    interne du Minitel 1B : les modèles VGP5 la fournissent (~8,5-13V),
    les plus anciens VGP2 ne l'ont pas - prévoir une alim externe pour
    l'ESP32 dans ce cas.
2026-07-06 fix(pagination): réinitialise la taille de texte avant "SUITE"
    Si une réponse laisse le mode double hauteur/largeur actif (tag {grand}
    non refermé avant la coupure de page), le message de pagination
    héritait de la taille double.
2026-07-06 fix(pagination): corrige le débordement de colonnes en taille double
    wrap() mesurait chaque ligne en repartant du mode normal (col_width=1),
    sans tenir compte du mode double hauteur/largeur laissé actif par un
    {grand} ouvert sur une ligne précédente et refermé plus loin (ex. une
    phrase clef en {grand} plus longue qu'une ligne). Les lignes suivantes
    étaient donc sous-dimensionnées et débordaient des 40 colonnes réelles
    à l'affichage. L'état se propage maintenant d'une ligne à l'autre.
    Corrige aussi un off-by-one dans visible_truncate qui pouvait laisser
    passer un caractère double largeur ne disposant que d'une colonne
    restante.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
2026-08-30 feat(firmware): ESP32-C3 prêt pour la production
    Le sketch était resté en configuration ESP32 classique et pointait sur un
    domaine d'exemple. Il est maintenant fonctionnel de bout en bout sur le
    montage réel (Minitel 2 Alcatel, TXS0108E, ESP32-C3 SuperMini).
    - identifiants sortis du fichier suivi : firmware/secrets.h (ignoré par
    git, modèle secrets.h.example) porte le WiFi et le token WS
    - WS_PATH inclut le token URL-encodé, sans quoi le serveur ferme la
    connexion en silence ; WS_HOST pointe sur le domaine de production
    - le token n'apparaît plus dans les traces série
    - reconnexion durcie : tampon TX vidé pendant une coupure (il se
    déversait dans la session suivante), heart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
2026-08-30 feat(display): dessins ASCII préservés via {art}...{/art}
    Un dessin ASCII demandé au LLM arrivait systématiquement illisible à
    l'écran, et le modèle n'y était pour rien : le pipeline le détruisait
    deux fois. strip_markdown() supprime les "_" et les "*" par paires, or
    ce sont les caractères de base de l'art ASCII ; puis wrap() fait un
    para.split() qui écrase les espaces d'alignement et refusionne les
    lignes.
    Le tag {art}...{/art}, dans la continuité du markup existant ({grand},
    {rouge}...), fait traverser le bloc intact : mis de côté avant les
    substitutions Markdown, puis chaque ligne préfixée d'un marqueur de
    contrôle qui survit à to_ascii et apply_minitel_markup, et que w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
2026-08-30 feat(firmware): diagnostiquer les redémarrages, assouplir le filet WiFi
    Des redémarrages semblaient survenir sans raison, sans qu'on puisse
    savoir si le filet WiFi en était responsable. La puce mémorise la cause
    de son dernier démarrage : on l'affiche désormais au boot, ce qui
    distingue un ESP.restart() volontaire d'un plantage, d'un watchdog ou
    d'un brownout — ces derniers n'ayant rien à voir avec le réseau.
    Le filet lui-même était trop brutal : il redémarrait après 2 min sans
    rien tenter. Il relance maintenant explicitement la connexion à 30 s
    (l'auto-reconnexion du core peut s'enliser sans jamais reprendre) et ne
    redémarre qu'en dernier recours, en l'annonçant. Une recon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
    [firmware.ino]
2026-08-30 feat(admin): supporte Gemini dans le formulaire des fournisseurs
    Gemini n'était configurable que par variable d'environnement, alors que
    Mistral et Claude avaient leur bloc dans l'admin. Le sélecteur, la clé
    API (masquée, avec lien vers AI Studio) et le choix du modèle sont
    désormais alignés sur les deux autres fournisseurs.
    Le point non évident : test_preset() et generate_prompt() ne
    connaissaient que Mistral et Claude. Sélectionner Gemini les aurait fait
    basculer silencieusement sur Mistral, avec un résultat trompeur dans
    l'admin. Elles gèrent maintenant les trois.
    L'appel Gemini est local à admin_ui plutôt que repris de
    minitel_gpt.call_gemini : ce dernier lit la clé et le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
2026-08-30 docs(hardware): spécifications techniques d'utilisation du Minitel 2
    Document France Télécom de février 1991 (STUM 2), utilisé pour établir
    le câblage et le comportement du terminal : brochage et vitesse par
    défaut de la prise péri-informatique (1200 bauds), aiguillages du
    standard Télétel en état local (clavier vers prise, prise vers écran,
    donc aucune configuration nécessaire), désactivation du dialogue local
    par Fnct+Sommaire, et codes émis par les touches de fonction.
2026-08-30 fix(display): lignes vides fantômes et ponctuation orpheline
    Deux défauts d'affichage visibles sur le vrai Minitel, tous deux dans
    wrap().
    Une ligne de pile 40 caractères remplit la rangée, ce qui fait déjà
    descendre le curseur à la suivante. Le CR LF émis ensuite par line()
    descendait une seconde fois et laissait une ligne vide. L'effet
    paraissait aléatoire puisqu'il ne touchait que les lignes pleines : sur
    une réponse observée, trois lignes vides correspondaient exactement aux
    trois lignes de 40 colonnes. Le découpage s'arrête maintenant une
    colonne avant, ce qui couvre aussi les blocs {art} tronqués.
    La typographie française place une espace avant ? ! : et ; . wrap()
    déc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
2026-08-30 fix(prompt): le modèle écrivait sa vérification au lieu de répondre
    L'instruction ajoutée avec le tag {art} demandait de « compter les
    colonnes ligne par ligne avant de repondre ». Un modèle léger l'a
    exécutée littéralement et à voix haute : à la question « tu es quel
    modèle », le Minitel a affiché un fragment de dessin ASCII suivi de
    « * Is it under 40 columns », en anglais, sans jamais répondre.
    L'instruction cadre maintenant {art} à une demande explicite de dessin,
    et ajoute trois consignes générales qui manquaient : ne jamais écrire
    son raisonnement, ne pas commenter ses contraintes d'affichage, et
    répondre dans la langue de la question.
    La largeur annoncée p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
2026-08-30 fix(admin): modèle actif faux dans les sélecteurs, tarifs retirés
    Les sélecteurs affichaient un modèle qui n'était pas celui utilisé.
    mistral_model(), claude_model() et gemini_model() lisaient uniquement le
    .env — absent en conteneur, faute de volume persistant — et ne
    consultaient jamais les variables d'environnement. Elles renvoyaient
    donc toujours le défaut codé en dur, alors que les fonctions de clé,
    elles, faisaient bien ce repli : d'où une clé correctement détectée à
    côté d'un modèle faux. env_or_default() applique désormais la même règle
    aux trois.
    Cas voisin : un modèle configuré hors de la liste proposée laissait le
    sélecteur sur sa première entrée, a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
2026-08-30 fix(llm): réponses tronquées avec Gemini, troncature signalée partout
    Le Minitel affichait des réponses coupées en plein mot. La cause : les
    tokens de réflexion des modèles Gemini récents sont décomptés du plafond
    de sortie. Mesuré sur gemini-3.5-flash : 668 tokens de réflexion sur les
    700 autorisés, 28 restants pour répondre, finishReason MAX_TOKENS.
    Augmenter le plafond ne corrige rien — le modèle réfléchit d'autant plus
    (1893 tokens sur 2000, 2526 sur 3000). La réflexion est donc désactivée :
    sur des réponses de quinze lignes de quarante colonnes, elle n'apporte
    rien. Les variantes Lite refusent ce paramètre avec un 400 alors qu'elles
    ne réfléchissent pas ; le r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
2026-08-30 fix(agile-en-seine): plus de la moitié du programme était coupée
    Le contenu de la page était tronqué à 4000 caractères sur les 9244
    extraits : 42 créneaux horaires arrivaient au modèle, 58 étaient jetés,
    et la coupure tombait en plein titre de session. Une question sur une
    conférence de fin de journée obtenait donc une réponse à côté, avec
    l'aplomb habituel et sans le moindre signe que l'information manquait.
    Le plafond passe à 12000, la valeur déjà retenue pour les fichiers de
    connaissance. La page entière tient dessous : les 100 créneaux passent,
    sans troncature.
2026-08-30 feat(admin): logo d'accueil configurable par personnalité
    Le logo était généré au démarrage par pyfiglet, en dur, et identique
    pour toutes les personnalités. Il se règle désormais depuis l'admin,
    comme le titre d'accueil, avec deux modes : un mot rendu dans l'une des
    dix polices proposées, ou un dessin ASCII collé tel quel — ce dernier
    l'emportant s'il est renseigné. Les trois champs vides laissent le logo
    MINITEL GPT en place.
    Deux garde-fous, parce qu'un logo trop grand ne se voit pas dans le
    formulaire mais saute aux yeux sur le Minitel : la largeur est plafonnée
    à 39 colonnes — pas 40, une ligne pleine ferait réapparaître les lignes
    vides fantômes corrigées plus t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
2026-08-30 fix(admin): conserver les espaces du mot du logo, placeholder générique
    Deux strip(), à la sauvegarde et au rendu, supprimaient les espaces de
    bord du mot à dessiner. Or le logo est centré avec une division
    entière : deux espaces initiaux décalent le rendu d'une colonne, seul
    moyen de rattraper un centrage qui tombe à côté selon la parité de la
    largeur. Ils sont désormais conservés ; un champ entièrement blanc
    compte toujours comme vide, sinon le logo disparaîtrait sans explication.
    Le texte d'aide du champ ne cite plus de nom particulier.
2026-08-31 fix(llm): prompt système Gemini via systemInstruction, réflexion coupée aussi dans l'admin
    Gemini était le seul des trois providers à ne pas utiliser le champ natif
    prévu pour le prompt système : il était injecté comme un faux premier tour
    `user` préfixé `[System]`, ce qui le noyait parmi les messages de la
    conversation et faisait commencer `contents` par deux tours `user`
    consécutifs. Claude passe par `system`, Mistral par un message
    `role: system` ; Gemini passe désormais par `systemInstruction`.
    `gemini_answer()` (admin) souffrait en plus d'une divergence non
    documentée : contrairement au terminal, elle ne coupait pas les tokens de
    réflexion. Mesuré sur gemini-3.5-flash a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
2026-08-31 fix(prompts): le prompt système du dépôt redevient un défaut vivant
    Le champ "prompt" de prompts.json était la seule source lue à l'exécution.
    Le "prompt_file" qui désigne un .txt de config/prompts/ n'était résolu que
    par ensure_prompts(), à la création du fichier - donc jamais sur un volume
    existant. Or prompts.default.json livre `"prompt": ""` : sur toute
    installation dont le prompts.json a été créé autrement (copie manuelle,
    version antérieure du mécanisme), le terminal envoyait au LLM un prompt
    sans aucune personnalité.
    Le filet de sécurité ne se déclenchait pas non plus :
    `p.get("prompt", FALLBACK_PROMPT)` ne renvoie le défaut que si la clé est
    absente, pas si e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
2026-08-31 fix(config): gemini-2.0-flash retiré par Google, défauts et DEPLOY.md à jour
    `gemini-2.0-flash` répond désormais `404 This model is no longer available`
    (vérifié par appel direct à l'API). Il servait encore de valeur par défaut
    à deux endroits, où l'absence de `GEMINI_MODEL` menait donc à un 404 dur
    sur chaque question : le défaut de `minitel_gpt.GEMINI_MODEL` et celui du
    docker-compose. Les deux passent à `gemini-3.5-flash-lite`, pour s'aligner
    sur `admin_ui.gemini_model()` qui était déjà à jour, comme `.env.example`.
    DEPLOY.md donnait ce même modèle en exemple, et listait `claude` comme
    fournisseur possible sans jamais mentionner `ANTHROPIC_KEY` ni
    `CLAUDE_MODEL` : sui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
2026-08-31 fix(affichage): un {grand} non refermé cassait toute la mise en page
    Constaté en production : une réponse entière affichée en lignes de trois
    mots. Le modèle avait ouvert `{grand}` tôt dans sa réponse sans le
    refermer. `{grand}` vaut DBL_SIZE (double hauteur et largeur), donc 2
    colonnes par caractère : la largeur utile tombe de 39 à 19 caractères et
    `wrap()` découpe en conséquence.
    Ni le serveur ni l'émulateur n'étaient en faute - vérifié des deux côtés,
    `visible_len()` compte bien les ESC à largeur nulle et la table serveur
    `{0x4C:1, 0x4D:1, 0x4E:2, 0x4F:2}` correspond au `SIZE_MAP` de
    minitel-test.html. Les deux ont fait ce qu'on leur demandait avec un état
    de taille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
2026-08-31 fix(prompts): le modèle repliait lui-même ses lignes, l'écran restait aux 3/4 vide
    Symptôme : des réponses affichées en lignes de 20 à 30 colonnes, avec un
    quart de l'écran inutilisé à droite. Ni le serveur ni l'émulateur n'étaient
    en cause - une sonde WebSocket sur la production montre `wrap()` qui
    découpe bien à 31-38 colonnes, et l'émulateur affiche fidèlement ce qu'il
    reçoit. C'est le modèle qui insérait ses propres retours à la ligne, vers
    25-30 caractères ; `wrap()` n'avait alors plus rien à faire, une ligne déjà
    courte restant courte. Reproduit au caractère près : le texte replié à la
    main donne [20, 28, 30, 0, 28, 25, 21] colonnes, contre [34, 34, 10, 0, 3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
2026-08-31 fix(prompts): demander une mise en page, pas seulement l'absence de repli
    Effet de bord du commit précédent : en interdisant les retours à la ligne
    au milieu d'une phrase sans jamais demander de structure, le modèle
    répondait par un pavé de quinze lignes d'un seul bloc. Les lignes
    remplissaient bien la largeur, mais un mur de texte sur un écran de 40
    colonnes se lit mal.
    Une seule consigne négative pousse le modèle au minimum : il a arrêté de
    couper, et il a arrêté de structurer avec. La consigne énonce donc
    maintenant deux règles opposées et numérotées - ne jamais couper une
    phrase, mais aérer la page - puis dit concrètement comment : un titre court
    en couleur seul sur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
2026-08-31 fix(pagination): casser les pages sur les fins de paragraphe
    Le découpage était une tranche fixe de CONTENT_ROWS lignes, ce qui donnait
    trois défauts visibles à l'écran :
    - une dernière page orpheline (19 lignes -> 18 + 1) ;
    - une page pouvant commencer par une ligne vide, ce qui se lit comme un
    écran cassé, voire une page ne contenant que du vide ;
    - des séries de lignes vides consécutives, qui gaspillent des rangées sur
    un écran qui n'en a que 24.
    Or une ligne vide qui tombe sur une coupure ne porte aucune information.
    paginate_lines() la mange, casse de préférence sur une fin de paragraphe
    proche de la limite, et si la page suivante recevrait moins de trois lignes,
    rec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
2026-08-31 fix(admin): l'éditeur revenait sur la personnalité active, et un fichier de connaissance pouvait être insupprimable
    Deux bugs distincts sur la même manipulation : éditer une personnalité
    inactive puis supprimer un de ses fichiers de connaissance.
    1. Le gabarit codait `selected` en dur sur la personnalité active, et toutes
    les actions redirigeaient vers / sans dire laquelle était en cours
    d'édition. Le sélecteur revenait donc sur l'active à chaque
    enregistrement, ajout ou suppression, et il fallait resélectionner sa
    personnalité. L'onglet, lui, était bien restauré via localStorage - d'où
    une incohérence d'autant plus déroutante.
    index() lit maintenant la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
2026-08-31 feat(dictee): dicter depuis un iPhone dans la session Minitel en cours
    Le clavier du Minitel décourage les questions longues. On veut dicter depuis
    un téléphone et voir le texte s'écrire sur l'écran du Minitel comme s'il
    était tapé, dans la conversation déjà ouverte.
    Le téléphone ne se connecte SURTOUT PAS à /ws : chaque connexion y lance sa
    propre run_session, il ouvrirait une deuxième conversation au lieu d'écrire
    dans celle du Minitel. Il fait donc du HTTP sur /dictee/inject, qui dépose
    des octets dans une file portée par le WSTerm de la session ; read_byte() la
    vide avant d'interroger la WebSocket, donc read_question reçoit de vraies
    frappes, sans que ni elle ni show_re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
2026-08-31 fix(affichage): un mot replié par le modèle restait seul sur sa ligne
    Vu sur l'écran : « Revolution francaise, Marie-Antoinette », puis « y » seul
    sur la ligne suivante, puis « fut enfermee avant son execution. » Le modèle
    avait replié sa phrase lui-même autour de 40 caractères, et wrap() traitant
    chaque "\n" comme une fin de paragraphe, le mot qui dépassait de sa ligne
    devenait un paragraphe d'un caractère.
    Le prompt lui interdit déjà d'insérer des retours à la ligne, et c'est la
    troisième fois que le sujet revient (e247ced, cc2bb3e) : plutôt que de
    reformuler la consigne une fois de plus, on répare au rendu. join_soft_wraps()
    recolle, avant le découpage, les lignes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
2026-08-31 feat(dictee): alias /dictee.html et jeton gardé dans le téléphone
    Deux frottements à l'usage, le téléphone étant destiné à passer de main en
    main pendant une démonstration.
    1. minitel-test.html est servi avec son extension, /dictee ne l'était pas :
    taper /dictee.html donnait un 404 sans indice. Les deux URL servent
    maintenant la même page.
    2. Le jeton était dans l'URL. Il restait donc affiché dans la barre d'adresse
    et dans l'historique Safari de l'appareil qu'on tend à quelqu'un. Il se
    saisit désormais une fois, dans un champ de type password, et vit dans le
    localStorage du téléphone. Un ?token=... reste accepté pour l'amorçage,
    mais il est aussitôt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
2026-08-31 fix(admin): les réglages du LLM n'atteignaient jamais le terminal
    Changer le fournisseur, le modèle ou une clé dans l'admin n'avait aucun effet
    sur le Minitel, et le message de confirmation affirmait faussement qu'un
    redéploiement suffirait. Deux causes cumulées :
    1. /save-llm écrivait dans .env, qui est à la racine de l'image (/app/.env).
    Seul /app/config est un volume : le fichier disparaît au redéploiement.
    2. Même conservé, il ne gagnait pas. load_dotenv() n'écrase pas une variable
    déjà présente dans l'environnement, et docker-compose.yml en fournit
    toujours une, avec un défaut (LLM_PROVIDER=${LLM_PROVIDER:-mistral}) ou
    vide pour les clés. Vérifié : un .e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
2026-09-01 refactor: minitel-test.html devient minitel.html
    Renommage simple, avec la route et les six références qui vont avec : le
    docstring de server.py, le commentaire de l'alias /dictee.html, le message
    « aucun Minitel connecté » de la page de dictée, DEPLOY.md, et les trois
    mentions du README (URL, arborescence, tableau de dépannage).
    Pas d'alias sur l'ancienne URL : /minitel-test.html répond maintenant 404.
    Vérifié sur gunicorn : /minitel.html en 200 et sert bien l'émulateur,
    /minitel-test.html en 404, /dictee.html et /healthz intacts.
    Reste une référence à l'ancienne URL dans .claude/settings.json (permission
    Bash pour un curl de vérification) : c'est un fichier de configurati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
2026-09-01 chore: titre de l'émulateur, « Conversation Minitel »
    Le titre de l'onglet annonçait Gemini, hérité de l'usage d'origine de la page,
    alors qu'elle parle au terminal quel que soit le fournisseur configuré.
2026-09-01 feat(personnalites): ajoute « Mistral », copie de l'assistant général
    Nouveau preset `mistral`, avec son propre config/prompts/mistral.txt, copie
    conforme d'assistant_general.txt : les deux peuvent diverger ensuite sans se
    gêner, chacun gardant son défaut vivant côté dépôt (resolve_prompt).
    Seul le titre d'accueil diffère, « *** MISTRAL *** », pour qu'on voie à
    l'écran quelle personnalité est active - les deux seraient sinon
    indiscernables.
    Ajouté en fin de liste, l'ordre des presets étant celui de l'écran GUIDE :
    les numéros des personnalités existantes ne bougent pas.
    À savoir pour le déploiement : prompts.json vit dans le volume et n'est jamais
    écrasé (entrypoi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
2026-09-01 feat(personnalites): Mistral prend l'accent
    La personnalité était une copie conforme de l'assistant général, donc sans
    caractère propre. Elle parle maintenant marseillais : tutoiement, "collegue",
    et une tournure du cru par réponse - une seule, la consigne insiste, sinon
    c'est du folklore et ça lasse au bout de trois questions sur un stand.
    Garde-fou explicite dans le prompt : l'exagération est dans le ton, jamais sur
    le fond. Chiffres, dates, adresses et faits restent exacts, et l'aveu
    d'ignorance est préféré à l'invention. Sans cette phrase, un prompt de
    personnage encourage le modèle à broder aussi sur les faits.
    Les trois messages d'écran suivent, c'est leur raison d'êt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
2026-09-01 chore(personnalites): titre d'accueil de Mistral
    « *** POWERED BY MISTRAL *** » remplace « *** MISTRAL, LE VENT DU SUD *** » :
    le titre annonce le fournisseur qui fait tourner le terminal, pas le vent de
    Provence. L'accent reste dans le prompt.
    26 colonnes sur 40, le centrage tient.
2026-09-01 feat(personnalites): les nouvelles personnalités du dépôt arrivent aussi sur un serveur déjà déployé
    Ajouter une personnalité au dépôt ne servait à rien en production : elle
    n'apparaissait ni dans l'admin ni sur l'écran GUIDE. prompts.json vit dans le
    volume et n'est jamais réécrit (entrypoint.sh en cp -rn, ensure_prompts() ne
    créait le fichier que s'il était absent), à raison, sinon chaque
    redéploiement effacerait les personnalisations. Seul le .txt du prompt
    arrivait, étant un fichier neuf. C'est ce qui vient de se passer avec
    « Mistral », invisible sur le serveur en ligne.
    ensure_prompts() fusionne maintenant, au démarrage et à chaque relecture, les
    personnalités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
2026-09-01 feat(personnalites): le logo « aqo minitel » entre dans le défaut du dépôt
    La personnalité Années 80 en ligne affiche un logo d'accueil configuré dans
    l'admin, absent du dépôt : une installation neuve repartait sur le logo
    MINITEL GPT. Les deux clés manquantes sont ajoutées, le reste du preset
    (titre, invite, message d'attente) étant déjà identique à ce que montre
    l'admin.
    pyfiglet replie le mot sur la largeur de l'écran : « aqo minitel » en police
    standard donne deux blocs, « aqo » puis « minitel ». Vérifié : 10 lignes de 31
    colonnes au plus, sous les limites de 12 lignes et 39 colonnes, et l'accueil
    complet tient en 20 rangées sur 24, ligne de saisie comprise.
    S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
2026-09-01 feat(personnalites): logo « 3615 MISTRAL » pour la personnalité Mistral
    Le clin d'oeil au code kiosque du Minitel, sur l'écran d'accueil.
    La police demandée était standard, qui coupait le logo : pyfiglet replie le mot
    sur la largeur de l'écran et « 3615 MISTRAL » y occupe trois blocs, dont le
    dernier - le « L » - tombe au-delà des 12 lignes de LOGO_MAX_LINES. L'écran
    aurait affiché « 3615 », « MISTRA », puis deux lignes d'un L à moitié dessiné.
    Sept des dix polices proposées ont le même problème sur ce mot. small le rend
    entier en deux blocs, 8 lignes et 38 colonnes, et l'accueil complet tient en 18
    rangées sur 24. cybermedium, mini et digital passent aussi, mais e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
2026-09-01 fix(deploiement): le volume gelait les fichiers de référence du dépôt
    La personnalité Mistral n'apparaissait toujours pas sur le serveur, et le
    correctif de fusion (78e45f0) n'y pouvait rien : il comparait avec un défaut
    périmé.
    entrypoint.sh amorçait tout le volume en cp -rn (no-clobber), y compris
    prompts.default.json et prompts/*.txt. Or ces deux-là sont du code, pas des
    données : ils restaient donc figés à leur version du PREMIER déploiement.
    Deux conséquences, la seconde passée inaperçue jusqu'ici :
    1. ensure_prompts() fusionnait depuis un prompts.default.json d'origine, sans
    la nouvelle personnalité. Seul mistral.txt arrivait, étant un fichier neuf,
    et il n'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
2026-09-01 feat(personnalites): %MODEL dans les messages d'écran
    « *** POWERED BY %MODEL *** » affiche POWERED BY MISTRAL, CLAUDE ou GEMINI
    selon le fournisseur réellement utilisé, sans avoir à retoucher la
    personnalité à chaque bascule.
    expand_vars() s'applique aux trois messages du preset, pas seulement au titre :
    c'est le même mécanisme, et se limiter au titre aurait appelé la question
    suivante. La casse est ignorée, %model et %MODEL fonctionnent.
    La valeur vient de llm_settings(), donc elle suit un changement de fournisseur
    dans l'admin sans redéploiement, comme le reste depuis d4888a3. load_preset()
    ne résout les réglages qu'une fois pour les trois messages, la fonction lisant
    un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
2026-09-01 feat(personnalites): deuxième ligne de titre facultative
    title_msg2 s'affiche juste sous title_msg, même couleur, et passe par les
    mêmes règles : ASCII, 40 colonnes, et la substitution de %MODEL.
    load_preset() rend les deux lignes jointes par un "\n" dans la case déjà
    existante du tuple, show_home() découpe dessus. Une ligne optionnelle ne
    justifiait pas de changer la signature de load_preset et de show_home, ni les
    appels côté server.py.
    Vide ou blanc, le champ ne consomme aucune rangée : l'écran est identique à
    avant, sans ligne blanche parasite. Au pire (logo de 12 lignes plus titre sur
    deux lignes), l'accueil occupe 22 rangées sur 24, la saisie sur la suivante.
    Côté adm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
2026-09-01 feat(personnalites): « POWERED BY %MODEL » sous le titre des trois personnalités
    Deuxième ligne de titre pour Années 80, Assistant général et Guide Paris : le
    fournisseur qui répond est annoncé sur l'écran d'accueil, ce qui est
    exactement l'usage visé par title_msg2 et %MODEL. Mistral n'en a pas, son
    titre principal le dit déjà.
    Vérifié pour les quatre personnalités et les trois fournisseurs : titres,
    invites et messages d'attente restent sous les 40 colonnes (36 au plus, pour
    « *** BIENVENUE DANS LES ANNEES 80 *** »), et l'accueil tient en 18 à 21
    rangées sur 24, logo compris.
2026-09-01 feat(personnalites): titres d'accueil retravaillés
    « AVEC %MODEL » remplace « POWERED BY %MODEL » en deuxième ligne : le terminal
    parle français, comme le reste des écrans.
    Deux titres principaux changent aussi. L'Assistant général annonce
    « *** LE FUTUR SUR VOTRE MINITEL *** » - c'est la seule personnalité qui n'est
    pas figée dans le temps (pas de fixed_year), elle tourne sur une machine de
    1985 et connaît la suite. Mistral prend « *** LE MINITEL DU SUD *** », qui
    laisse son accent se découvrir à la première réponse plutôt que de l'annoncer.
    Vérifié sur les quatre personnalités avec MISTRAL, le nom de fournisseur le
    plus long : 36 colonnes au maximum sur 40, et 19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
2026-09-01 feat(prompts): l'assistant général vit dans les années 80 et connaît la suite
    Le prompt colle maintenant au titre d'accueil « LE FUTUR SUR VOTRE MINITEL » :
    la machine est de 1985, le savoir ne l'est pas. C'est la personnalité sans
    fixed_year, donc la seule qui n'a aucune date injectée et peut parler
    librement de ce qui vient après.
    Deux corrections sur la ligne ajoutée : « tu accés à » -> « tu as accès à », et
    les accents retirés, comme le reste du fichier. Le prompt n'est pas affiché sur
    le Minitel, les accents n'y casseraient donc rien, mais ces fichiers sont
    écrits en ASCII par convention et le modèle a moins de raisons d'en produire
    s'il n'en lit pas.
    Vérifié :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
2026-09-01 Revert "feat(prompts): l'assistant général vit dans les années 80 et connaît la suite"
    Retour au prompt d'assistant neutre : la ligne « Tu vis dans les annees 80 mais
    tu as acces a toutes les donnees du futur » est retirée. Le reste du fichier
    est inchangé, et le titre d'accueil « LE FUTUR SUR VOTRE MINITEL » reste, lui,
    en place.
2026-09-01 feat(admin): revenir au prompt par défaut du dépôt, et deux correctifs sur la date
    Un prompt enregistré dans l'admin gagne pour toujours sur le .txt du dépôt
    (resolve_prompt), et il n'y avait aucun moyen d'en sortir depuis l'interface :
    vider le champ et enregistrer ne fait rien, une valeur vide étant ignorée -
    volontairement, pour qu'un formulaire renvoyé sans prompt n'efface pas la
    personnalisation. Il fallait éditer prompts.json dans le volume à la main.
    C'est ce qui a fait qu'un « Assistant général » se présentait comme figé au
    31 décembre 1989 : un vieux prompt de personnage dormait dans son champ, alors
    que ni son .txt ni fixed_year ne prévoyaient quoi que ce soit d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
2026-09-01 refactor(date): l'injection de la date suit la personnalité, plus la session
    Le test de personnalité de l'admin ne disait pas la même chose que le Minitel
    sur une question de date : with_fixed_date() vivait dans server.py, n'était
    appelé que par run_session, et relisait la personnalité ACTIVE - pas celle
    qu'on est en train de tester ni même d'éditer. C'est l'outil avec lequel on
    diagnostique le terminal : il doit lui être fidèle.
    fixed_date_note(preset, key) part donc dans minitel_gpt, prend la personnalité
    en argument, et load_preset() l'ajoute en fin de prompt. Le terminal l'obtient
    sans y penser, et le test de l'admin appelle la même fonction avec la
    personnalité testée. se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
2026-09-01 fix(date): une personnalité pouvait rester bloquée en 1989, et l'admin doublait les appels LLM
    Deux choses, la première signalée à l'usage.
    1. fixed_year était impossible à neutraliser pour les identifiants annees80 et
    annees80bis : `preset.get("fixed_year") or FALLBACK_FIXED_YEARS.get(key)`
    remettait 1989 quoi qu'on écrive dans prompts.json, et l'admin n'expose pas
    ce champ. La personnalité était donc enfermée dans son époque, sans issue.
    Le champ, DÈS QU'IL EST PRÉSENT, fait maintenant autorité, y compris à null,
    0 ou "" pour dire « pas de date figée ». Le repli ne sert plus qu'à ce pour
    quoi il existe : les prompts.json déployés avant l'ajout du ch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
2026-09-01 fix(date): le modèle inventait la date faute qu'on la lui donne
    Guide de Paris annonçait « nous sommes le 19 mai 2024 », Mistral « mardi 19 mai
    2026 » : la date n'était injectée QUE pour les personnalités figées dans le
    temps. Ailleurs, le modèle n'a aucune notion d'aujourd'hui et comble le vide.
    date_note() (ex fixed_date_note) ajoute donc toujours la ligne, avec l'année
    réelle par défaut. fixed_year ne fige plus que l'année : le mécanisme sert
    maintenant aussi à informer, pas seulement à contraindre.
    Le jour de la semaine est ajouté, pour la même raison - il était inventé lui
    aussi - et calculé sur l'année EFFECTIVE : le 1er septembre 1989 était un
    vendredi, aujo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
2026-09-01 fix(prompts): un fichier de connaissance ne doit pas répondre à la place du reste
    « Qui est le president ? » renvoyait le president d'aqoba. La faute à la phrase
    qui introduit les fichiers de connaissance : « utilise ces informations EN
    PRIORITE pour repondre » demande au modèle de répondre à travers ces documents
    quelle que soit la question. Avec une fiche intitulée « AQOBA - LA SOCIETE QUI
    T'HEBERGE », toute question ambiguë se résout contre elle.
    Le cadrage dit maintenant ce qu'on attend vraiment : ces documents font
    autorité sur LEUR sujet, et pour toute autre question il faut les ignorer
    complètement, sans y ramener la conversation ni supposer qu'une question
    général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
2026-09-01 fix(prompts): l'exception aqoba passe du fichier de connaissance au prompt des Années 80
    La fiche aqoba (config/knowledge/, hors dépôt) contenait une section
    « SI TA MEMOIRE EST FIGEE EN 1989 » : mémoire figée au 31 décembre 1989,
    « c'est cette société qui t'a rallumé », ton d'époque à tenir. Des consignes de
    PERSONNAGE dans un document de FAITS.
    Attachée à une autre personnalité, elle les lui applique : c'est ainsi que
    l'Assistant général se présentait comme figé au 31 décembre 1989 et « tout
    droit sorti du futur grâce à aqoba qui m'a rallumé », alors qu'il n'a ni
    fixed_year ni rien de tel dans son prompt. J'avais d'abord soupçonné un prompt
    enregistré dans l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
2026-09-01 fix(prompts): une question générale n'est pas une question sur les documents fournis
    « Qui est le president ? » répondait encore sur la direction d'aqoba - et à la
    première personne, « notre site », « notre structure ». Le cadrage général de
    f473f9a ne suffisait pas : il disait quoi faire quand la question porte sur les
    documents, sans dire ce qu'est une question qui n'y porte pas.
    Deux ajouts au cadrage, l'un et l'autre nommant le symptôme observé :
    - « Une question generale ("qui est le president ?", "quelle est la capitale ?")
    porte sur le monde, PAS sur ces documents : n'y cherche la reponse que si la
    question nomme leur sujet. »
    - « Tu n'es pas l'auteur de ces do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
2026-09-01 fix(date): donner la date réelle faisait refuser de répondre
    « Qui est le president de la Republique ? » renvoyait « depend de l'actualite
    politique et des resultats des elections en cours, consultez les medias ». Le
    biais aqoba avait disparu, mais la réponse ne valait rien.
    C'est l'effet de bord de a3f1d84 : on annonce « nous sommes le 1er septembre
    2026 » à un modèle dont l'entraînement s'arrête avant, sans lui dire quoi faire
    de cet écart. Il en déduit que tout a pu changer et se dérobe - comportement
    raisonnable, question mal posée.
    La note porte donc maintenant la consigne qui manquait : « tes connaissances
    s'arretent avant cette date : reponds avec ce que tu sais, e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
2026-09-01 fix(date): la consigne anti-refus servait d'excuse au modèle
    « Je n'ai pas cette information en memoire car mes connaissances s'arretent
    avant septembre 2026 » : le modèle recopiait mot pour mot la phrase censée
    l'empêcher de se dérober. Nommer la limite pour demander de l'ignorer revient
    à la lui rappeler, et elle est plus saillante que l'ordre qui suit.
    La note ne contient donc plus que la date. Ce qui restait de 1132ac0 est
    retiré ; le reste du correctif (date toujours injectée, jour de la semaine,
    année figée) est inchangé.
    Vérifié : les deux notes se terminent sur la date, aucune consigne derrière,
    19 assertions sur la date et les trois autres suites concernées repass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
2026-09-02 feat(prompts): personnalite "Le Guide galactique" (Marvin)
    Le Guide du voyageur galactique, tenu par Marvin : depression chronique,
    ennui cosmique, ironie resignee. Deux garde-fous dans le prompt, sans quoi
    le personnage se mange la reponse : la melancolie est le ton et jamais une
    excuse pour esquiver (une reponse qui se contente de se plaindre est ratee),
    et 42 est reserve a la Grande Question, sinon il le sert a tout.
    Un seul tic de langage par reponse, sur le modele de la tournure du cru de
    mistral.txt. Le prompt ne parle pas des 40 colonnes : MARKUP_INSTRUCTIONS
    interdit deja au modele de commenter ses contraintes d'affichage.
    Pas de fixed_year : Marvin n'est figé dans aucune epoque.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
2026-09-02 feat(prompts): personnalite "3615 IA", vulgarisation de l'IA
    Explique l'IA avec humour sans sacrifier l'exactitude. Les garde-fous qui
    portent le prompt : repondre en une phrase AVANT d'expliquer (sinon le
    preambule mange les 600 caracteres), une blague par reponse pas davantage
    ("une reponse drole mais floue est une reponse ratee"), ni hype ni
    catastrophisme, et distinction systematique entre l'etabli, le debattu et
    le speculatif - c'est la que ca derape quand un modele parle de lui-meme.
    Logo "3615 IA" en police standard : 5 lignes, 35 colonnes, accueil a 15
    rangees sur 24. Sous-titre a 20 colonnes une fois %MODEL developpe.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
2026-09-02 feat(aes): personnalite "Agile en Seine" et module conf_aes dedie
    Repond sur le programme de la conference, en particulier "quelles sont les
    prochaines sessions" a l'heure de Paris. Le prompt tient le cadre : le
    programme injecte est la seule source (jamais de session inventee, jamais de
    recitation de memoire), les deux journees ne se melangent pas, "prochaines" =
    heure de debut posterieure a l'heure courante, bascule sur le lendemain quand
    la journee est finie, et trois sessions par reponse au maximum.
    Tout Agile en Seine part dans services/conf_aes.py, isole pour etre
    supprimable d'un bloc apres la conference (le fichier, les deux appels a
    prompt_note, la personnalite et son .txt). server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
2026-09-02 feat(aes): descriptions des sessions, avec deux caches
    La page du programme ne porte que l'entete des sessions : la description est
    sur la fiche de chaque session, soit 50 pages a ouvrir, ~23 s. Impensable
    pendant qu'un visiteur attend, d'ou deux caches.
    Descriptions -> config/aes_descriptions.json (volume, gitignore), rafraichi en
    tache de fond. La liste REST (wp-json/wp/v2/programme?per_page=100) donne les
    50 fiches et leur date de modification : seules les nouvelles et les modifiees
    sont rouvertes, et une session retiree du programme sort du cache.
    Programme -> garde 5 minutes en memoire et reconstruit en tache de fond. Il
    coutait 7 s de releve (page de 2 Mo) A CHAQUE QUESTION, avant me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
2026-09-02 fix(aes): un resume invente est pire qu'un resume absent
    Vu sur le vrai terminal : a "details session olivier", le modele a annonce
    jour, heure, salle et intervenants justes, puis a redige un resume de son cru,
    plausible et faux. Le prompt interdisait d'inventer sessions, horaires et
    salles, pas explicitement les descriptions. C'est maintenant sa regle la plus
    dure, avec la raison : annoncer a un participant le contenu d'une conference
    qu'il ira voir est la faute la plus grave possible ici.
    Deux defauts du cache derriere ce comportement :
    - Le texte du programme est fabrique avec les descriptions disponibles a cet
    instant. Construit avant leur arrivee, il restait servi PROG_TTL de plus :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
2026-09-02 fix(minitel): un champ de plus de 40 colonnes n'est pas un repli
    Vu sur le vrai Minitel : "Intervenants : Antoine Marcou, Olivier Marquet,
    Ludovic HAVEL Cette conference explore..." - le debut du resume se lisait
    comme un intervenant de plus. join_soft_wraps recollait les deux lignes.
    Le garde-fou sur les champs ("Adresse : ...") ne regardait que la ligne
    SUIVANTE, jamais la ligne courante : un champ de 61 colonnes sans point final
    etait donc pris pour une phrase repliee. Or le modele replie vers 40 : au-dela
    de 40 colonnes il n'a PAS replie, la coupure qui suit est voulue.
    Compare au code d'origine sur cinq cas : seul le cas fautif change (recolle ->
    separe). Le repli subi en milieu de ph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
2026-09-02 fix(aes): les sessions sont en parallele, deux formats de reponse
    "Les sessions de 14h" les listait toutes et debordait l'ecran. La cause n'est
    pas la reponse mais ma regle "trois sessions au maximum" : tous les creneaux
    de cette conference sont en parallele, de 1 a 7 sessions simultanees (7 le
    mardi a 10h30, 6 le mercredi a 14h et 16h30). Sur une question de creneau, en
    cacher revient a choisir la salle a la place du participant.
    Deux formats desormais, selon la question :
    - creneau ("les sessions de 14h") ou prochaines sessions -> toutes celles du
    creneau, sur une seule journee, en compact : une ligne par session, titre
    ramene a l'essentiel puis la salle entre parentheses, sans interv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
2026-09-02 feat(aes): la description de la session s'affiche en entier
    Trois verrous empechaient le texte complet d'arriver a l'ecran :
    - Le cache stockait la description DEJA coupee a 320 caracteres. Il garde
    maintenant le texte integral, la troncature se faisant a l'injection : le
    plafond devient un simple reglage (DESC_MAX_CHARS, porte a 4000, soit aucune
    coupure en pratique - mediane 1215, la plus longue 3968) et en changer ne
    coute plus un releve de 50 pages.
    - Le prompt demandait de la reformuler en une ou deux phrases, l'inverse de ce
    qu'on veut. Il exige desormais l'affichage integral, mot pour mot, sans
    resumer ni reecrire : c'est le texte de l'intervenant. Le budget de 600
    cara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
2026-09-02 feat(aes): la description garde ses paragraphes
    Les fiches de session sont ecrites en <p> (7 paragraphes en mediane) et le
    nettoyage HTML ecrasait tous les blancs : la description sortait en un pave
    de 24 lignes d'un seul tenant, illisible sur 40 colonnes.
    _texte() prend donc un mode paragraphes : les fins de <p>, <br> et <li>
    deviennent des retours a la ligne, les <p>&nbsp;</p> d'espacement sont jetes.
    Ce mode reste INTERDIT pour les cartes du programme, dont chacune doit tenir
    sur une seule ligne - sinon on retombe sur le melange horaire/salle corrige
    dans dca63db.
    Le prompt demande de restituer ces paragraphes separes par une ligne vide, et
    precise que la mise en page est la seule chose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
2026-09-02 fix(minitel.html): affichage adapte au mobile
    Balise viewport manquante : le mobile rendait la page en largeur desktop
    puis dezoomait, empechant les container queries deja en place de
    s'appliquer. Ajoute aussi un font-size 16px sur les inputs et un layout
    en colonne pour la devbar de test sous 480px, pour eviter le zoom auto
    de Safari iOS au focus et tout debordement horizontal.
    Claude-Session: https://claude.ai/code/session_01Y8HDxMauH994cXQGcaFjJ3
2026-09-02 docs(README): Gemini est configurable dans l'admin, pas seulement par env
    Meme correction que CLAUDE.md (1e21499) : le formulaire /save-llm gere
    Gemini au meme titre que Mistral et Claude depuis 5bdddfa/5d037ab.
    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
2026-09-03 fix(web): favicon sur l'emulateur et la page de dictee
    Seules les pages de l'admin declaraient un <link rel=icon> : les onglets
    "Conversation Minitel" et "Dictee Minitel" affichaient le globe generique du
    navigateur. Memes liens que l'admin (favicon 32x32 et icone Apple 180x180),
    en chemin absolu /assets/ pour marcher depuis /minitel.html comme depuis
    /dictee, la route /assets/ etant publique.
    L'apple-touch-icon compte surtout pour la dictee : cette page est faite pour
    etre ajoutee a l'ecran d'accueil de l'iPhone (elle declare deja
    apple-mobile-web-app-capable) et n'avait qu'une capture d'ecran en guise
    d'icone.
    Verifie avec le serveur lance : les deux images repondent 200 en image/png et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
2026-09-04 feat(guide): choix du modele d'IA depuis le Minitel, touche SUITE
    Depuis l'ecran GUIDE, SUITE ouvre un ecran dedie ou A, B et C basculent entre
    Mistral, Claude et Gemini. Un fournisseur sans cle est affiche mais inerte,
    marque "(sans config)" et sans nom de modele en dessous : annoncer un modele
    qui ne repondra pas serait pire que de ne rien dire. L'acces n'est annonce
    nulle part, et l'ecran des personnalites ne perd pas une ligne.
    FNCT, la touche a laquelle on pense d'abord pour ce genre de raccourci, ne
    peut pas servir : c'est un modificateur, seule elle n'emet rien sur la ligne
    serie et "FNCT puis GUIDE" arrive au serveur comme un simple GUIDE. Une
    sequence de touches reellement emises e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
2026-09-04 feat(minitel): clavier a deux casses, la touche Majuscule retrouve son role
    Par defaut le Minitel n'a qu'une seule casse : tout ce que tape le visiteur
    part en capitales et la touche fleche vers le haut n'a aucun effet sur les
    lettres. ESC 3A 69 45 (PRO2 START MINUSCULE), envoye une fois a l'ouverture de
    la session, debloque les deux casses - les lettres partent en minuscules et
    Majuscule donne la capitale, coup par coup. Rien a decoder cote serveur : le
    terminal envoie deja le bon octet et fait l'echo lui-meme. Les Minitel 1, sans
    minuscules, ignorent la commande.
    L'emulateur devait suivre, sinon la commande s'affichait : son decodeur ne
    consomme qu'un octet apres ESC, il aurait donc laiss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
2026-09-04 fix(minitel): clavier en capitales, le mode d'origine
    Retour aux capitales pour la frappe. La commande inverse est envoyee (PRO2
    STOP MINUSCULE, 1b 3a 6a 45) plutot que de ne rien envoyer du tout : le mode
    survit a la deconnexion, donc un terminal bascule en minuscules par la version
    precedente y resterait jusqu'a extinction. Chaque session le remet en
    capitales quoi qu'il se soit passe avant.
    La marche arriere est ecrite dans le commentaire de la constante : remplacer
    STOP 0x6A par START 0x69 redonne les deux casses, rien d'autre n'est a
    toucher. Le choix du modele continue d'accepter les deux casses.
    L'emulateur garde son decodage des sequences protocole : il est necessaire
    pour cette co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
2026-09-04 feat(firmware): liste de reseaux WiFi essayes dans l'ordre
    WIFI_SSID2 et WIFI_SSID3 sont facultatifs (#ifdef) : un secrets.h d'avant
    cette liste continue de marcher tel quel, avec un seul reseau. Le partage de
    connexion d'un telephone a sa place ici, c'est le reseau qu'on a toujours sur
    soi quand on emmene le Minitel quelque part.
    connectKnown() essaie chaque reseau 12 s a tour de role, LED clignotante.
    setup() refait le tour indefiniment au lieu de bloquer sur un seul reseau, ce
    qui corrige un defaut au passage : si le WiFi n'etait jamais la au demarrage,
    la carte restait coincee dans sa boucle d'attente et le filet "2 min ->
    redemarrage" du loop ne tournait jamais - il ne s'applique qu'ap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
    [firmware.ino]
2026-09-04 feat(firmware): configuration WiFi depuis le Minitel, sans ordinateur
    Quand ni le reseau memorise ni la liste de secrets.h ne repondent, l'ESP32
    prend la parole sur le Minitel avant d'ouvrir la WebSocket : le pont reste
    strictement octet a octet, aucune machine a etats ne peut avaler une frappe
    une fois la conversation demarree.
    Le SSID ne se tape JAMAIS, il se choisit au chiffre dans la liste du scan -
    c'est ce qui rend la chose praticable, un SSID ayant autant de casse et de
    symboles tordus qu'un mot de passe. Trois regles rendent cette liste lisible :
    reseaux caches jetes, bornes portant le meme SSID fusionnees (sans quoi un
    reseau de salle occupe quatre lignes a lui seul), tri par signa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
    [firmware.ino]
2026-09-04 fix(firmware): l'ecran de configuration ne s'affichait jamais
    Constate sur la carte : demarrage en boucle, aucun WiFi trouve, et pas
    d'interface. Deux defauts se combinaient.
    1. Le scan etait refuse. WiFi.scanNetworks() lance juste apres des
    WiFi.begin() qui viennent d'echouer renvoie un code NEGATIF - la connexion
    est encore en cours, la radio n'est pas disponible. La boucle de
    depouillement ne tournait donc pas et la liste ressortait vide. On remet
    maintenant la radio au repos avant (disconnect(true), mode(WIFI_STA),
    200 ms), on retente une fois si c'est encore refuse, et on ecrit la raison
    sur le port serie.
    2. Zero reseau valait sortie silencieuse : "if (!netCount) ret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
    [firmware.ino]
2026-09-04 refactor(firmware): serveur et transport dans secrets.h, plus dans le code
    Le .ino portait un nom de domaine de production et l'IP locale d'une machine.
    Ce n'est pas un secret, mais c'est propre a une installation : les laisser la,
    c'etait devoir modifier un fichier suivi par git pour un simple test, avec le
    risque de commiter son IP au passage - alors que le SSID du WiFi, qui n'est
    pas plus secret, vivait deja dans secrets.h. La vraie ligne de partage de ce
    fichier n'est pas "secret / public", c'est "mon installation / le projet".
    USE_LOCAL, WS_HOST_PROD, WS_PORT_PROD, WS_HOST_LOCAL et WS_PORT_LOCAL passent
    donc dans secrets.h. Le .ino n'en garde AUCUNE valeur, seulement des #error
    qui dis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
    [firmware.ino]
2026-09-05 docs(fiche): fiche d'atelier en Markdown, PDF genere pour l'impression
    La fiche existait en PDF seulement, sans source : impossible a maintenir. Elle
    devient documentation/fiche-atelier.md, et build-fiche.sh en tire le PDF
    imprimable - pandoc pour le HTML, Chrome en mode headless pour l'impression.
    Pas de LaTeX dans la chaine (absent de la machine), et aucune police a
    telecharger : premiere version via Google Fonts, abandonnee en voyant pandoc
    echouer a les embarquer, donc polices systeme et generation hors ligne.
    Les schemas sont en ASCII dans des blocs de code : lisibles dans le .md,
    diffables, et rendus tels quels a l'impression - c'est aussi l'esprit du
    projet.
    Trois corrections de fon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
2026-09-05 docs(fiche): §4 revu - schema complet, reglage par le Minitel, condensateur conditionnel
    Trois corrections sur l'alimentation par le Minitel, toutes venues de questions
    posees devant l'etabli.
    1. Le condensateur etait presente comme une etape obligatoire. Il ne l'est pas :
    le module a deja son condensateur de sortie, la carte ESP32 les siens, et le
    buck debite 3 A la ou l'ESP32-C3 demande des pointes de 300 mA. Le probleme
    n'est pas le courant mais la brutalite de l'appel au passage en emission.
    C'est donc devenu un correctif conditionnel, avec le critere de decision que
    le firmware fournit deja : la cause du dernier demarrage affichee au boot.
    BROWNOUT -> il en faut un.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
2026-09-05 docs(fiche): couleurs des fils du cable DIN
    Les cables DIN 5 broches vendus tout faits suivent presque tous la meme
    convention : noir = 1 (RX), cuivre = 2 (masse), rouge = 3 (TX, 5 V), jaune = 4
    (handshake), blanc = 5 (12 V). C'est ce qu'on a en main au moment de brancher,
    pas un numero de broche : les couleurs sont donc reportees dans les trois
    schemas de cablage, en plus du tableau du §2.
    Avec l'avertissement qui va avec : cette convention n'est pas une norme, une
    serie peut inverser deux couleurs, et se tromper ici amene les 12 V du fil
    blanc sur un GPIO. Deux verifications d'une minute lèvent le doute - continuite
    entre le fil cuivre et le blindage, puis voltmetre sur le fil blanc qui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
2026-09-05 docs(fiche): 5 V mesures sur la broche 4, a isoler et jamais a la masse
    La broche 4 (fil jaune, "PT" handshake) n'est pas un fil mort : 5 V mesures
    sur ce Minitel 2 Alcatel. Comme la broche 5 et ses 12 V, c'est une sortie -
    la mettre a la masse ferait debiter l'appareil dans un court-circuit. Or
    "mettre a la masse une broche inutilisee" est le reflexe naturel, d'ou
    l'encadre : ce reflexe vaut pour une entree d'un circuit qu'on maitrise, pas
    pour une broche d'un appareil dont on ignore ce qu'elle pilote. Et rien ne lit
    ces fils cote ESP32, donc rien ne flotte dans un sens genant : la protection
    est mecanique - couper court, gainer, rabattre le long du cable.
    La mesure est consignee aux trois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
2026-09-05 docs(fiche): variante C - pull-up simple, confirmee par la norme STUM1B
    La sortie TX du Minitel est documentee (STUM1B) comme un collecteur ouvert
    TTL 5V necessitant un pull-up externe, pas une sortie poussee activement a
    5V. Une seule resistance de 10k vers le rail 3,3V de l'ESP32 suffit donc a
    fixer le niveau haut, sans diviseur : verifie sur ce Minitel 2 Alcatel
    (~3,3V mesures au repos, transmission montante validee au test 6).
    Ajoute comme troisieme option a cote de A (TXS0108E) et B (pont diviseur),
    avec une note ouverte sur la tension avec le Test 4 existant (broche 3
    mesuree a ~5,0V a vide, probablement du reseau de detection de sens du
    TXS0108E branche a ce moment-la plutot qu'un pu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
2026-09-05 docs(fiche): retire la note sur la tension au repos du TX Minitel
    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
2026-09-05 fix(fiche): la variante B (pont diviseur) ne fonctionne pas sur TX
    Un pont diviseur abaisse une tension reellement appliquee en haut du pont.
    La broche 3 du Minitel est une sortie collecteur ouvert (norme STUM1B,
    deja citee pour la variante C) : elle ne pousse jamais 5V vers le haut,
    elle tire vers la masse au niveau bas et flotte au repos. Rien n'alimente
    donc le haut de la resistance de 10k dans le montage B - la resistance de
    20k vers la masse tire le point milieu vers 0V au lieu des 3,33V calcules.
    Le ~5,0V releve un temps au Test 4 venait tres probablement du reseau de
    detection de sens du TXS0108E (variante A) branche au meme moment, pas de
    la ligne TX elle-meme.
    Retire la variante B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
2026-09-06 feat(firmware): force le mode peri-informatique via PRO3 (experimental)
    Remplace la manip manuelle Fnct+T puis A par une sequence protocole
    Teletel envoyee sur la liaison serie elle-meme (aiguillage clavier/ecran
    vers la prise peri-informatique). Documentee pour le Minitel 1B
    (bibliotheque Minitel1B_Hard), non verifiee sur ce Minitel 2 Alcatel : a
    tester sur le vrai materiel avant de la considerer acquise.
    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
2026-09-06 fix(firmware): repete l'aiguillage PRO3 au lieu d'un envoi unique au boot
    Le premier envoi partait juste apres Minitel.begin(), potentiellement avant
    que le Minitel ait fini de demarrer lui-meme (sortie de veille, reset
    interne) - perdu en silence dans ce cas. Repete maintenant pendant 5s
    (idleTick()/loop()), y compris pendant l'attente de connexion WiFi qui peut
    a elle seule depasser ce delai.
    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
    [firmware.ino]
2026-09-06 docs(fiche): trois montages complets au lieu de variantes a croiser
    La fiche separait le cablage (§3) et l'alimentation (§4) : au lecteur de
    croiser les deux axes pour savoir quoi brancher. Elle presente maintenant
    trois montages complets, liaison de donnees ET alimentation :
    1. pull-up simple, alimente par l'USB - celui par lequel commencer
    2. pull-up simple, alimente par le Minitel via le MP1584EN - autonome
    3. TXS0108E, alimente par l'USB - le montage historique
    Le pont diviseur disparait completement : il ne fonctionne pas sur cette ligne
    (sortie collecteur ouvert). Ce qu'il a appris survit dans le montage 1, qui
    explique pourquoi un pull-up et non un diviseur : il n'y a pas de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
2026-09-06 docs: commandes clavier du Minitel, et README remis a jour pour l'ESP32-C3
    Fiche, §6 : le reglage qui compte s'appelle le mode peri-informatique, et la
    fiche ne le disait nulle part - par defaut le Minitel route clavier et ecran
    vers son modem interne, cet aiguillage les renvoie vers la prise DIN. Sans lui,
    le cablage est parfait et il ne se passe rien.
    Le tableau des commandes gagne la vitesse de la prise (Fnct+P puis 1 = 1200
    bauds, 3 = 300, 4 = 4800, 9 = 9600 selon le modele) avec le moyen
    mnemotechnique qui compte devant la machine : le chiffre est le premier chiffre
    de la vitesse. Ces combinaisons ne servent qu'a revenir en arriere apres une
    fausse manoeuvre, le symptome etant sans am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
2026-09-13 fix(aes): la note "description pas encore chargee" partait a chaque question
    La verification `"Description :" not in prog` ne correspondait jamais au
    texte reellement genere par _sessions() ("Description (a restituer telle
    quelle, un paragraphe par ligne) :") : la sous-chaine exacte n'existe nulle
    part, meme quand une vraie description est bien injectee. La note qui dit
    au modele "dis que ca arrive, n'affirme jamais qu'il n'y a pas de resume"
    partait donc a CHAQUE question, sans rapport avec l'etat reel du cache.
    Mistral suivait cette instruction a la lettre (d'ou "Le resume n'est pas
    encore disponible. Je peux le charger si vous le souhaitez" - une offre
    qui n'existe pas, le systeme ne fai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
2026-09-13 fix(markup): une balise mal formee s'affichait telle quelle a l'ecran
    `\{(/|[a-z]+)\}` ne reconnaissait que la forme exacte de la consigne.
    {Cyan}, { cyan }, {en cyan} ou un {/art} orphelin ne correspondaient a
    rien : ni traduits, ni jetes, ils traversaient tout le pipeline et
    s'affichaient sur le Minitel ("{m cyan}Mercredi 23 septembre", vu sur une
    session Agile en Seine).
    La regex accepte maintenant toute accolade courte qui ressemble a une
    balise (lettres, espaces, tirets, barre de fraction) et _markup_code() y
    cherche un mot connu ; ce qui n'est pas reconnu est jete plutot
    qu'affiche. Une accolade qui n'a rien d'une balise ("{cle: valeur}")
    reste intacte.
    Meme principe que strip_markdo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
2026-09-13 feat(aes): gabarit fixe pour l'affichage des sessions
    La presentation changeait a chaque reponse : filets une fois sur deux,
    couleurs variables, champs dans le desordre. Le modele ne dessine donc
    plus rien, il remplit des champs - {fiche} (titre/quand/ou/avec) pour une
    session, {liste} pour plusieurs - et conf_aes.render() dessine la fiche
    encadree ou la liste a deux lignes par session, identique a chaque fois.
    Deux details qui comptent :
    - chaque ligne rendue porte ART_MARK, sinon join_soft_wraps() recolle le
    filet au titre qui le suit (une ligne pleine passe pour un repli subi)
    et wrap() ecrase l'alignement des champs ;
    - render() n'intervient qu'a l'affichage, pas avant de ranger la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
2026-09-13 fix(aes): le jour sur chaque ligne de session, et pas de recherche racontee
    Le jour ne figurait qu'une fois, en en-tete de grille, avec une
    cinquantaine de sessions en dessous : le modele attribuait au mauvais jour
    une session lue cinquante lignes plus bas. Vu sur le vrai Minitel, la meme
    session (mardi 22) annoncee "mercredi 23" a une question, "mardi 22" a la
    suivante. fetch() connait pourtant le jour de chaque grille : _sessions()
    le recopie desormais en tete de CHAQUE ligne.
    Deux consignes de lecture ajoutees, sur des comportements constates :
    - un prenom seul ("olivier") est une recherche : parcourir tout le
    programme avant de conclure a l'absence ;
    - repondre directement, sans annon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
2026-09-13 fix(aes): le gabarit etait ignore - consignes remontees et filet de securite
    Le modele reprenait la FORME du gabarit (les barres verticales) sans le
    bloc qui l'entoure : la ligne s'affichait brute, barres comprises
    ("- Jour 1 (mardi 22), 15:00 - 15:45 | Amphitheatre Berlioz | L'IA va
    obliger...", vu a l'ecran).
    Deux causes, deux correctifs :
    - les consignes etaient posees APRES le programme, soit derriere ~75 ko de
    descriptions : elles passaient a la trappe. Elles sont maintenant AVANT,
    avec un rappel d'une ligne apres le programme. La regle est aussi plus
    nette : toute session citee passe par un bloc, y compris un resultat de
    recherche, y compris quand il n'y en a qu'une.
    - une lig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
2026-09-13 fix(aes): afficher les intervenants dans une liste, et ne pas etoffer
    Sur une recherche par nom ("fabrice"), la liste rendait trois sessions
    sans afficher un seul intervenant : rien, a l'ecran, ne permettait de voir
    sur quoi le modele avait cru matcher - et la premiere ne correspondait
    pas.
    Le gabarit {liste} accepte donc un dernier champ facultatif "avec: X, Y",
    rendu sur sa propre ligne. Reconnu a son etiquette et non a sa position :
    "quand | salle | titre" continue de marcher tel quel.
    Cote consigne : ne citer que les sessions ou le nom figure vraiment parmi
    les intervenants de la ligne - pas de session ajoutee parce que son sujet
    ressemble, parce qu'elle ouvre la journee, ou pour etoff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
2026-09-13 fix(aes): fiabilise ce que la personnalite dit du programme
    Releve du cache : 57 sessions (29 le mardi, 28 le mercredi), 7 nouvelles en
    11 jours. Six defauts trouves en verifiant le chemin jour/heure, dont deux
    observes sur de vraies reponses du modele a des heures simulees.
    1. Comptage. A "les prochaines confs" le modele a annonce "6 sessions a 10:30"
    la ou il y en avait 7. Compter 57 lignes dans 86 ko de contexte est ce qu'un
    LLM rate, et l'erreur est invisible sans verification alors qu'elle envoie
    quelqu'un devant une salle qui n'existe pas. Chaque journee porte maintenant
    ses comptes calcules par le code ("Sessions par creneau : 10:30 (7), ...") et
    le prompt interdit de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
2026-09-13 fix(aes): le programme n'etait plus injecte si la personnalite etait renommee
    Signale depuis le Minitel : taper "fabrice" remontait des sessions ou ce nom
    ne figure pas. Reproduit a l'identique en coupant une seule chose, le
    programme injecte - sans lui le modele repond de memoire et invente avec
    aplomb : "09:40 De l'Agilite a l'Impact (Amphi Arc-en-Ciel), par Fabrice,
    Alexis et Guillaume", une session, une salle et des intervenants qui
    n'existent pas. Le vrai Fabrice Bloch tient deux sessions le mercredi 23.
    Ecarte au passage : le modele. Six ont ete essayes sur la question exacte -
    gemini-3.5-flash, 3.5-flash-lite, 2.5-flash, mistral-small, medium et large -
    tous rendent les deux bonnes s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
2026-09-13 fix(aes): interdit de completer une recherche avec des sessions hors sujet
    Signale depuis le Minitel : "fabrice" remontait trois sessions, dont une ou ce
    nom ne figure nulle part - ni titre, ni intervenants, ni description (verifie
    dans le bloc injecte : seules deux lignes contiennent "fabrice").
    Diagnostic fait en se connectant a la production en WebSocket, comme le fait
    minitel.html : le defaut s'y reproduit 2 fois sur 3, alors que douze essais en
    local etaient propres. La difference n'est ni l'injection - les deux vraies
    sessions de Fabrice Bloch remontent a chaque fois - ni la personnalite active,
    ni l'historique de conversation : c'est le MODELE. La production tourne sur
    gemini-3.5-fla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
2026-09-13 fix(aes): le rendu des sessions mangeait une grille de morpion
    Vu a l'ecran : une grille de morpion sortait en "1 2" / "3" au lieu de
    " 1 | 2 | 3". La cause n'est pas le modele, c'est conf_aes.render() : il
    traitait TOUTE ligne a deux barres verticales comme une session a redessiner,
    et il etait applique a toutes les reponses, quelle que soit la personnalite.
    Le commentaire pariait sur un faux positif "theorique" - il a suffi d'un
    morpion.
    Deux verrous plutot qu'un :
    - render() ne s'applique plus qu'a la personnalite d'Agile en Seine, a qui ce
    gabarit appartient. Un module evenementiel, fait pour etre supprime apres la
    conference, n'a pas a abimer les reponses des autres personnalites.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
2026-09-13 fix(markup): {art} vaut pour tout ce dont l'alignement compte
    La consigne reservait {art} au cas "on te demande explicitement un dessin, un
    logo ou un schema". Une grille de morpion n'entre dans aucune des trois, donc
    le modele la dessinait sans protection : wrap() ecrase alors les espaces
    d'alignement et recolle les lignes, et la grille sort de travers (vu a
    l'ecran).
    Elle couvre maintenant tout ce dont l'ALIGNEMENT compte - dessin, logo,
    schema, grille de jeu, plateau, tableau en colonnes, calendrier - et garde le
    garde-fou dans l'autre sens, avec sa raison : du texte courant encadre en
    {art} cesse d'etre decoupe par le terminal et sort tronque a droite.
    Verifie avec de vraies reponses s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
2026-09-13 fix(ecran): une reponse a peine plus longue qu'une page tenait sur deux
    Vu a l'ecran sur une partie de morpion : la reponse partait en 15 + 4 lignes,
    donc deux pages, dont une avec quatre lignes et quatorze rangees vides - et la
    grille se retrouvait sur la page precedente, invisible au moment de jouer.
    La cause est arithmetique. Un ecran de 24 rangees porte CONTENT_ROWS lignes de
    contenu, une ligne vide et les deux lignes de pied ("-- SUITE --"). Or la
    DERNIERE page n'a pas de pied : elle rend la main a l'invite de saisie. Elle
    peut donc prendre ces deux rangees, et une reponse de 20 lignes tient
    finalement en une seule page - 20 lignes + ligne vide + "Repondez ou SOMMAIRE"
    + son saut + ">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
2026-09-13 fix(art): la premiere ligne d'un dessin perdait son indentation
    Vu a l'ecran : la premiere rangee d'une grille de morpion decalee d'un cran
    par rapport aux suivantes, alors que le modele l'avait bien dessinee.
    L'extraction du bloc, `\{art\}[ \t]*\n?(.*?)`, mangeait les blancs qui suivent
    la balise MEME sans retour a la ligne. Quand le modele colle la premiere rangee
    a la balise - "{art} . | O | ." sur une seule ligne, ce qu'il fait souvent -
    l'espace de gauche de cette rangee partait avec, et elle seule se retrouvait
    decalee. Le reste du bloc, lui, etait intact : d'ou une grille visiblement de
    travers sur une seule ligne.
    Les blancs ne sont desormais manges QUE s'ils accompagnent un retour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
2026-09-13 fix(markup): retire les exemples de jeux de la consigne globale
    MARKUP_INSTRUCTIONS part a CHAQUE question, pour toutes les personnalites. J'y
    avais ecrit "une grille de jeu (morpion, puissance 4, bataille navale)" et
    justifie la compacite par "une partie dont la grille s'est retrouvee sur la
    page precedente est injouable : le joueur ne la voit plus au moment de jouer".
    Trois noms de jeux et un vocabulaire de partie dans le prompt systeme
    permanent : un modele reprend ce qu'on lui met sous les yeux, et c'est
    exactement l'amorce qui fait proposer un morpion a quelqu'un qui demandait
    autre chose. Le role de cette consigne est de proteger l'alignement, pas de
    lister des jeux.
    La liste redevie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
2026-09-13 fix(ecran): couper les pages avant un item de liste, pas au milieu d'une phrase
    Vu a l'ecran : une enumeration coupee en plein milieu d'un item - "...la super
    societe qui fait tourner ce" en bas de la page 1, "terminal !" seul en haut de
    la page 2, qui n'avait que trois lignes.
    paginate_lines() ne connaissait qu'une seule coupure propre : la ligne vide.
    Or le modele ecrit ses listes a tirets SANS ligne vide entre les items - il
    n'existait donc aucune coupure acceptable dans la fenetre de recherche, et le
    decoupage tombait ou il tombait, au milieu d'une phrase.
    Le debut d'un element de liste est desormais une coupure acceptable lui aussi.
    Sur le cas signale : 16 + 5 au lieu de 18 + 3, l'ite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
2026-09-13 fix(aes): les titres de session etaient abreges par le modele
    Vu a l'ecran : "Je ne sais pas coder. J'ai livre...", "Une journee de Product
    Manager..." - des titres coupes par des points de suspension, donc
    meconnaissables sur le programme affiche dans le hall.
    Le code n'y etait pour rien : _entree_liste() PLIE les lignes trop longues,
    il ne tronque pas. La coupe venait d'une consigne du prompt que j'avais
    ecrite - "le titre ramene a l'essentiel (raccourcis-le s'il est long)" -
    datant du format compact d'une ligne par session, AVANT que le gabarit ne
    sache replier sur deux lignes. Elle etait devenue inutile, et nuisible.
    Le prompt demande maintenant le titre entier, et GABARIT_INSTRUCTIONS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
2026-09-19 fix(firmware): "sta is connecting, cannot set config" - un reseau sur deux n'etait jamais essaye
    Remonte du moniteur serie : "E (12343) wifi:sta is connecting, cannot set
    config". L'horodatage designe le coupable - 343 ms apres l'expiration de
    WIFI_TRY_MS (12 s).
    WiFi.disconnect() sans argument ne coupe qu'une connexion ETABLIE. Quand notre
    delai expire avant que la pile n'ait fini de s'associer, la tentative est
    toujours en cours : le pilote refuse alors la nouvelle configuration et le
    WiFi.begin() qui suit est IGNORE en silence. Ce n'est donc pas qu'une ligne de
    log - le reseau suivant de la liste n'etait jamais reellement essaye, il
    echouait seulement au bout de ses 12 secondes, et le to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
    [firmware.ino]
2026-09-19 fix(firmware): dire POURQUOI le WiFi echoue, et nommer les causes de redemarrage
    Trois angles morts constates en debuggant une connexion qui echouait sur la
    carte, sans qu'aucun message ne permette d'avancer.
    1. "pas de reponse" pour tout. Le firmware ecrivait la meme chose qu'il
    s'agisse d'un mot de passe faux, d'un reseau absent ou d'une box qui refuse
    - trois pannes aux corrections opposees. La pile WiFi, elle, connait la
    raison : elle la donne dans son evenement de deconnexion. On la capte et on
    l'affiche en clair. Sur le cas reel, ca a donne "association expiree
    (raison 4)" : le point d'acces avait repondu et le mot de passe n'etait pas
    en cause, ce qui elimine d'embl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
    [firmware.ino]
2026-09-19 feat(firmware): n'aiguiller le Minitel qu'en cas d'usage, et viser la bonne borne
    Regle demandee : tant qu'il n'y a pas de WiFi, on ne touche pas au Minitel - on
    n'a rien a lui montrer, et le basculer pour rien lui fait perdre son affichage.
    L'aiguillage PRO3 ne part donc plus au demarrage, mais aux DEUX seuls moments
    ou l'on va ecrire sur le terminal : juste avant l'ecran de configuration, et
    une fois le WiFi obtenu. Le journal serie y gagne aussi : les lignes PRO3 ne
    noient plus les messages WiFi.
    Diagnostic WiFi, suite du meme debug sur la carte :
    - Le scan ENUMERE ce qu'il voit, avec niveau et nombre de bornes. "3 reseaux
    distincts" ne disait pas si celui qu'on cherche etait la ; et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
2026-09-19 fix(firmware): viser une borne ne doit pas interdire les autres
    Le ciblage par BSSID + canal, ajoute en 262ff87 pour corriger la raison 4
    sur un reseau maille, a cree l'echec inverse : WiFi.begin() avec une
    adresse et un canal ne cherche plus le RESEAU, il cherche CETTE borne.
    Si elle ne repond pas - occupee, canal change depuis le scan, renvoi vers
    une autre borne - le pilote conclut "reseau introuvable" (raison 201)
    sans jamais s'adresser a la seconde borne du meme nom.
    Constate a la maison : deux demarrages de suite, meme piece, l'un echoue
    sur les trois reseaux connus alors que le scan qui suit voit Skynet a
    -59 dBm avec deux bornes, l'autre passe du premier coup sur une borne
    unique a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
    [firmware.ino]
2026-09-19 revert(firmware): ne plus viser une borne, c'est le travail du pilote
    Le ciblage par BSSID + canal (262ff87, puis son repli 26af304) partait
    d'un bon diagnostic et d'une mauvaise reponse. Choisir sa borne, c'est le
    metier de la pile WiFi : elle le fait avec le releve de l'instant, alors
    que notre scan a jusqu'a une minute. Viser, c'est en plus s'interdire
    toutes les autres bornes du meme nom - la pile conclut "reseau
    introuvable" plutot que d'essayer la voisine.
    Et le probleme etait ailleurs : la raison d'echec change a chaque essai
    (2, 4, 201, 203, et jusqu'a aucune reponse du tout) sur TOUS les reseaux,
    y compris un partage de connexion a deux metres releve a -75 dBm la ou
    une carte saine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
    [firmware.ino]
2026-09-19 fix(firmware): repasser la liste des reseaux, un rate n'est pas un echec
    L'association echoue par intermittence : raison 4 sur un reseau qui passe
    au demarrage suivant, au meme endroit, sans que rien n'ait bouge. Un seul
    essai par reseau suffisait alors a ouvrir l'ecran de configuration WiFi -
    autrement dit a demander un mot de passe au visiteur pour un rate
    passager, ce qui serait la pire des reactions en conference.
    connectKnown() repasse donc la liste jusqu'a WIFI_PASSES fois, avec un
    releve neuf a chaque tour. Le scan coupe la radio et la laisse se ranger :
    il fait aussi office de pause entre deux tentatives. Le bouton BOOT
    interrompt toujours l'attente.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
    [firmware.ino]
2026-09-19 fix(firmware): la pause allait apres le rallumage de la radio, pas avant
    b2d1a8c coupe la radio avant chaque tentative pour annuler une connexion
    en cours. La pause de 100 ms qu'il posait juste apres l'arret ne servait
    a rien : c'est au RALLUMAGE que l'etage radio se recalibre, et le
    WiFi.begin() partait dans la foulee, sans un instant de repit.
    D'ou une "association expiree" (raison 4) par intermittence, a tous les
    niveaux de signal et sur tous les reseaux - releve a -35 dBm sur un
    partage de connexion a deux metres, ce qui excluait la portee, l'antenne
    et la configuration de la box. Le seul point commun des echecs etait
    d'arriver juste apres un cycle d'extinction de la radio.
    Co-Authored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
    [firmware.ino]
2026-09-19 feat(firmware): insister 20 s sur l'aiguillage, une fois par seconde
    Le Minitel peut sortir de veille bien apres l'ESP32 : une fenetre de 5 s
    suppose qu'il ecoute deja, alors qu'une sequence PRO3 envoyee trop tot est
    perdue sans le moindre signe. Fenetre portee a 20 s, intervalle a 1 s :
    20 envois au lieu de 10, pour un cout inchange sur la ligne (10 octets par
    envoi, soit 83 ms a 1200 bauds).
2026-09-19 fix(firmware): ne plus couper la radio entre deux tentatives
    Annuler la tentative precedente reste necessaire, sinon le pilote refuse
    la nouvelle configuration ("sta is connecting, cannot set config") et le
    reseau suivant n'est jamais essaye (b2d1a8c). Mais esp_wifi_disconnect()
    y suffit : couper la radio par-dessus etait le remede de trop.
    Symptome : c'est le PREMIER essai qui echoue, celui qui suit le scan -
    donc apres deux extinctions coup sur coup, scanNets() eteignant deja la
    radio pour scanner. Releve "association expiree" (raison 4) a -35 dBm sur
    la premiere tentative, puis connexion du second coup sur un reseau a
    -77 dBm. Ce n'est pas une affaire de signal, c'est l'etage radio qu'on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
    [firmware.ino]
2026-09-19 revert(firmware): aiguiller le Minitel des le demarrage
    262ff87 n'ouvrait la fenetre PRO3 qu'aux deux moments ou l'on ecrit
    vraiment sur le terminal - ecran de configuration, et WiFi obtenu - pour
    ne pas deranger un Minitel deja en service pendant la recherche de
    reseau. Moins fiable a l'essai : le moment ou le terminal est le plus
    susceptible d'ecouter est justement la mise sous tension, quand les deux
    appareils demarrent ensemble.
    La fenetre est donc rouverte des setup(), et les deux autres restent -
    reaffirmer un aiguillage deja pris est sans effet.
    [firmware.ino]
2026-09-19 fix(firmware): aiguillage toutes les 500 ms pendant 10 s
    Retour au rythme d'origine (57ff332, 500 ms) avec une fenetre deux fois
    plus longue. 14fcd9a avait espace les envois a une seconde sur 20 s : la
    cadence compte plus que la duree, le Minitel devant etre pris des qu'il
    est pret.
    [firmware.ino]
2026-09-19 fix(markup): un titre en couleur ne colle plus a la phrase suivante
    Le modele ouvre une couleur, ecrit un titre en capitales, la referme - et
    enchaine sur la meme ligne, sans espace ni retour a la ligne. A l'ecran :
    "BIENVENUE SUR LE MINITELSalut ! Je suis ton assistant virtuel...", vu sur
    le vrai Minitel. La consigne demande pourtant un titre "seul sur sa
    ligne" ; comme pour le Markdown, on ne compte pas dessus.
    separe_titre_colle() insere donc la ligne vide manquante. Deux garde-fous,
    parce qu'une couleur sert aussi a souligner un mot au fil d'une phrase :
    la balise doit OUVRIR la ligne, et son contenu etre en capitales ET faire
    au moins deux mots. "il faut {rouge}ABSOLUMENT{/} eviter" et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
2026-09-19 feat(dictee): "Envoyer" grise tant qu'il n'y a rien a transmettre
    En mode Direct, le bouton appelait sync(), exactement ce que l'evenement
    input declenche deja 250 ms apres la derniere frappe : il ne faisait rien
    de plus et laissait croire que rien n'etait parti tant qu'on ne l'avait
    pas touche.
    Plutot que de le masquer, il est desormais actif uniquement s'il reste
    quelque chose a transmettre. En Direct il est donc gris en marche
    normale, et ce gris dit "tout est passe" - une information que rien
    d'autre ne donnait. Il se rallume seul des qu'un envoi echoue (pas de
    session Minitel, serveur injoignable), cas frequent quand la page est
    ouverte avant que le Minitel soit connecte : le rattrapag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
2026-09-19 feat(firmware): un octet toutes les 2 min pour que l'ecran ne s'eteigne pas
    Le Minitel eteint son ecran quand plus aucun caractere ne lui parvient. La
    STUM 2 documente ce mecanisme (chapitre "La veille video", p. 4) avec un
    delai de trois heures ; celui du montage s'endort en cinq a dix minutes.
    Or une session ou personne ne tape laisse la ligne parfaitement muette :
    le serveur n'envoie rien entre deux questions. L'ecran s'eteignait donc en
    pleine session, et se rallumait "tout seul" cinq minutes plus tard - en
    realite au redessin de l'accueil declenche par IDLE_TIMEOUT.
    Un NUL suffit a reculer l'echeance : caractere de remplissage Videotex,
    sans effet a l'affichage. Il part uniquement si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
2026-09-19 chore(ecran): retour au sommaire apres 4 min au lieu de 5
    Entre deux visiteurs, le terminal doit se remettre a l'accueil sans garder
    la conversation du precedent. Le delai servait aussi, par effet de bord, a
    rallumer l'ecran mis en veille : ce n'est plus son role depuis le battement
    de coeur du firmware (d7c3385).
    Il borne aussi l'attente de SUITE pendant la pagination : 4 min laissent
    largement le temps de lire une page, 2 min commenceraient a bousculer un
    lecteur lent.
2026-09-19 fix(ecran): un titre en {grand} mangeait la ligne du dessus
    Vu a l'ecran : "ou jeu[...]t-etre tester un" - la phrase "ou jeux video ? Ou
    peut-etre tester un petit {grand}WARGAMES{/} ?" amputee de seize caracteres
    en plein milieu, alors que rien ne manquait dans ce que le modele avait
    ecrit.
    Sur Videotex, un caractere en double hauteur est dessine avec la rangee du
    curseur pour moitie BASSE : sa moitie haute deborde sur la rangee du dessus
    et l'efface. Les 8 caracteres de WARGAMES, larges de 16 colonnes, avaient
    donc efface les colonnes 7 a 22 de la ligne precedente. Le compte tombe au
    caractere pres.
    La largeur etait traitee de longue date (_COLUMN_WIDTH_BY_SIZE_BYTE,
    bound_double_size) ;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
2026-09-20 docs(readme): la page de dictee n'etait mentionnee nulle part
    dictee.html est une fonctionnalite a part entiere - elle sert a faire
    essayer le terminal a quelqu'un qui n'a jamais tape sur un clavier de
    Minitel - et le README n'en disait pas un mot. Nouvelle section :
    a quoi elle sert, ses deux modes, pourquoi elle passe par /dictee/inject
    plutot que par /ws, ses deux limites (session ouverte obligatoire, dictee
    en attente pendant la lecture d'une reponse) et le sort du jeton.
    minitel.html y etait deja : deux phrases en plus pour dire a quoi il
    sert, et la page de dictee ajoutee a l'arborescence.
2026-09-20 docs(readme): annoncer la dictee et l'emulateur des l'introduction
    Les deux pages n'etaient decrites qu'au fil du document, la ou on ne les
    cherche pas : la dictee vocale est ce qui fait sourire les visiteurs, et
    l'emulateur est ce qui permet d'essayer le projet avant d'avoir un Minitel
    sous la main. Quatre lignes en tete, avec un lien vers chaque section.
    La section Securite precise aussi le sort des routes de la dictee :
    /dictee/status et /dictee/inject exigent le jeton, la page /dictee non -
    l'exiger le laisserait dans l'historique du telephone.
2026-09-20 docs(claude): la fiche d'atelier a trois montages, pas deux variantes
    4292fe2 avait remplace les variantes a croiser par trois montages complets
    et decrits de bout en bout ; le fichier de contexte, lui, annonçait
    toujours "les deux variantes de cablage - TXS0108E ou pull-up simple".
2026-09-22 fix(firmware): les essais 2 et 3 ne visaient pas le bon reseau
    Vu au log, sur un demarrage a la conference : deux "E wifi:sta is connecting,
    cannot set config" coup sur coup (16 225 ms et 20 483 ms), suivis chaque fois
    d'une "authentification expiree (raison 2)" portant le nom du reseau suivant.
    Le commentaire de demarrerConnexion() prevoyait le cas : "a surveiller si ce
    message reapparait, la pause de 250 ms serait alors trop courte". C'est
    arrive. Quand la pile n'a pas fini de se ranger dans ces 250 ms, le pilote
    refuse la nouvelle configuration, WiFi.begin() est ignore EN SILENCE, et la
    radio continue de s'acharner sur le reseau precedent pendant que le log
    annonce le suivant. L'ecart en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
    [firmware.ino]
2026-09-22 fix(firmware): rendre au premier essai son temps de se ranger
    576b777 remplacait le delay(250) de demarrerConnexion() par une attente qui
    sort DES que l'evenement d'arret arrive - donc parfois au bout de quelques
    millisecondes. C'etait supprimer sans le vouloir un plancher qui protegeait
    le PREMIER essai : il suit scanNets(), qui vient de couper la radio, et le
    commentaire d'origine disait deja que ce qui manquait la n'etait pas la
    brutalite mais le temps de se ranger.
    L'attente garde donc son plafond (on n'attend pas un evenement qui ne vient
    pas) mais ne rend plus la main avant 250 ms.
    Non compile : pas de toolchain Arduino dans l'environnement.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
    [firmware.ino]
2026-09-22 fix(firmware): definir les plafonds d'attente avant de s'en servir
    1f06b8b posait ARRET_WIFI_PLANCHER_MS apres attendreArretWifi(), alors que la
    fonction s'en sert : un macro doit etre defini avant son usage dans le texte,
    donc le fichier ne compilait pas. Le bloc des trois #define passe devant la
    fonction.
    Faute a moi : j'ai pousse 1f06b8b sans compilateur pour l'attraper. Un
    controle "macro utilisee avant sa definition" passe desormais sur tout le
    fichier - seuls restent deux rappels en prose dans l'en-tete, sans effet.
    Claude-Session: https://claude.ai/code/session_01GkTBeqmK17CCn8SujsHk9a
    [firmware.ino]
2026-09-22 fix(firmware): couper la radio quand la pile refuse deux fois
    Releve au log, en conference : essai 1 en "authentification expiree", puis
    essais 2 ET 3 refuses deux fois chacun ("sta is connecting, cannot set
    config"). Un seul des trois reseaux a donc ete reellement essaye, et le
    terminal est reste hors ligne alors qu'un autre aurait pu repondre.
    esp_wifi_disconnect() - WiFi.disconnect(false) - n'extrait pas une station
    coincee en pleine poignee de main : lui laisser plus de temps ne change
    rien, le second refus arrive 2 s apres le premier. Couper la radio, si.
    C'est ce que faisait b2d1a8c, et le retirer en 5044de6 a ramene la panne -
    5044de6 s'appuyait sur un essai reussi a la maison, ou le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
    [firmware.ino]
2026-09-22 fix(firmware): essayer d'abord les reseaux que le scan voit
    En conference, les deux reseaux de la maison etaient en tete de secrets.h
    et passaient avant celui de la salle - pourtant le seul a portee. Deux
    echecs a subir avant d'essayer le bon, et autant d'occasions de rester
    bloque en chemin.
    connectKnown() fait donc deux tours : les reseaux PRESENTS dans le scan,
    puis les absents (qui peuvent etre a SSID cache). L'ordre de secrets.h ne
    decide plus de rien, ce qui evite d'avoir a le reecrire selon l'endroit ou
    l'on se trouve - et de reflasher pour ca.
    Le numero d'essai disparait du log : il n'a plus de sens quand l'ordre est
    choisi a l'execution.
    Compile : esp32:esp32:esp32c3, 89% de flas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
    [firmware.ino]
2026-09-22 fix(ecran): une grille dessinee sans {art} perdait son alignement
    Vu a l'ecran sur une partie de morpion : " | X |" s'affichait "| X |" et
    " | | X" s'affichait "| | X". Les cases vides ecrasees, les colonnes ne
    tombaient plus en face des separateurs, la grille etait illisible - alors que
    le modele l'avait correctement dessinee.
    wrap() fait un para.split() : tout groupe d'espaces devient une espace unique.
    C'est precisement ce contre quoi {art} existe, et le commentaire de _ART_RE
    raconte deja une grille de morpion partie de travers pour une raison voisine.
    Il manquait seulement de ne pas dependre du modele pour poser la balise : il
    ne l'avait pas ecrite.
    _proteger_grilles() encadre don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
